Froster2406/BAT2024/Dokumentation/presentation/BAT_Beispiele_Zwischenpraesentation.docx

LEDs

Mikrofon

Speicher

V1-1 Back

V1-1 Front

Adapter

Debugger

Stefano Nicora

Entwicklung einer PCB zur Analyse von Umgebungslärm
