Froster2406/BAT2024/Dokumentation/presentation/BAT-EIT-FS24-Präs-Nicora-1507146.pptx

## BAT FS24

Gerät zur Überwachung von Umgebungslärm

Schlusspräsentation – 19.06.2024

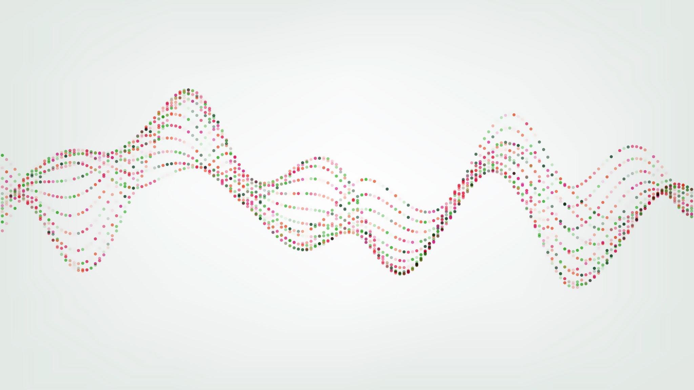
[picture p70: figure]

## Ablauf

Ausgangslage
Ziel
Implementation
Resultate
Fallstricke
Fazit & Ausblick

## Ausgangslage

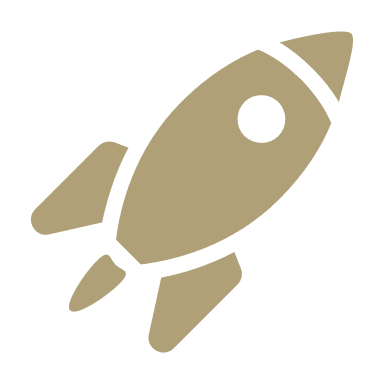
[picture p71: figure]
Rakete
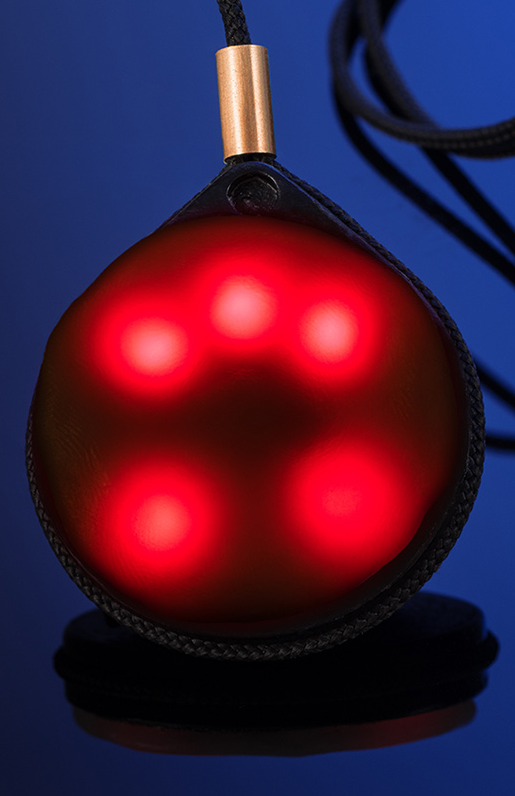
[picture p72: figure]

Bestehende Geräte unhandlich, gross, optisch nicht schön
Masterarbeit von Sophie Willener ( hEar)
Mockup bestehend aus:
LED-Ring
ESP32-Mikrocontroller
Kondensator-Mikrofon
Akku (nicht im Betrieb)
Gesamtdurchmesser 40mm

## Ziel

- Schalldruckpegel visuell darstellen
- MEMS-Mikrofon
- Akkubetrieb für >12h (Arbeitstag)
- BLE-fähig
- USB-C Ladefähigkeit
- Optisch ansprechendes Design
- Messungen speichern und bei Bedarf übertragen
(Übertragung ist nicht Inhalt dieser Arbeit)

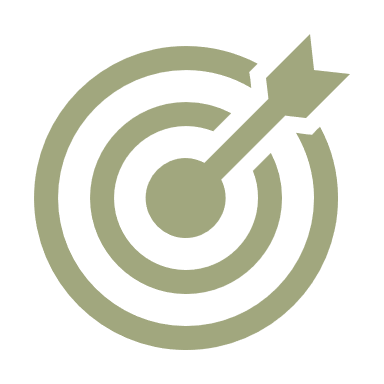
[picture p73: figure]
Volltreffer
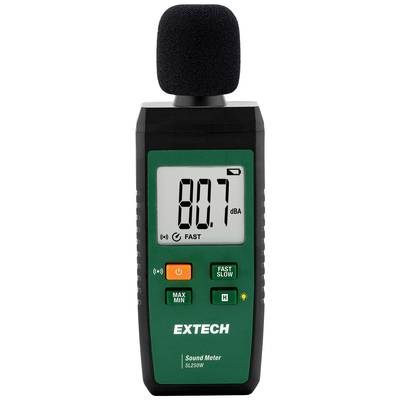
[picture p74: figure]

## Software

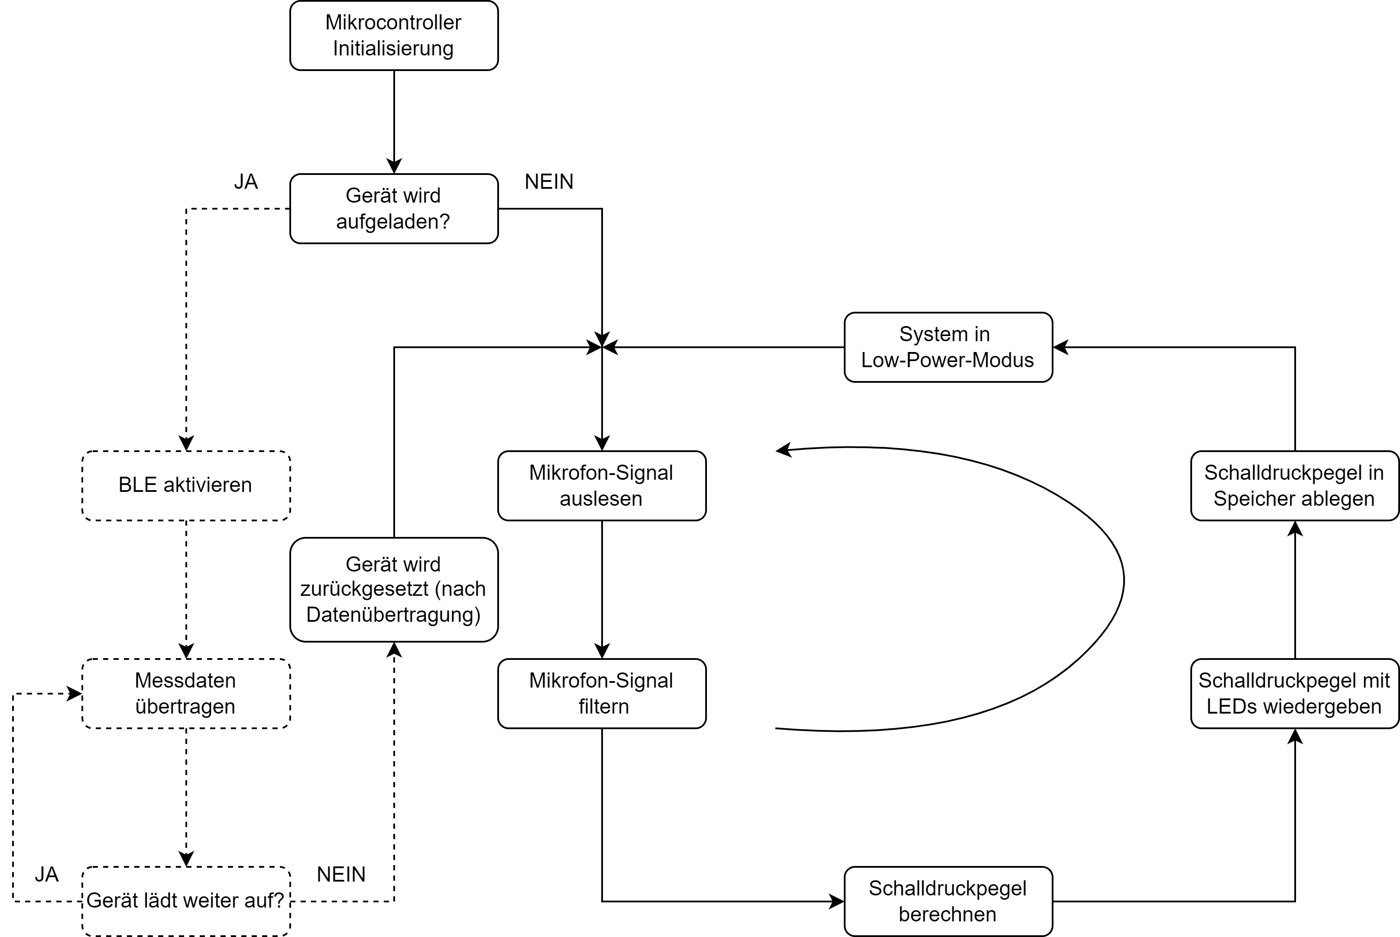
[picture p75: figure]

## Signalverarbeitung Überblick

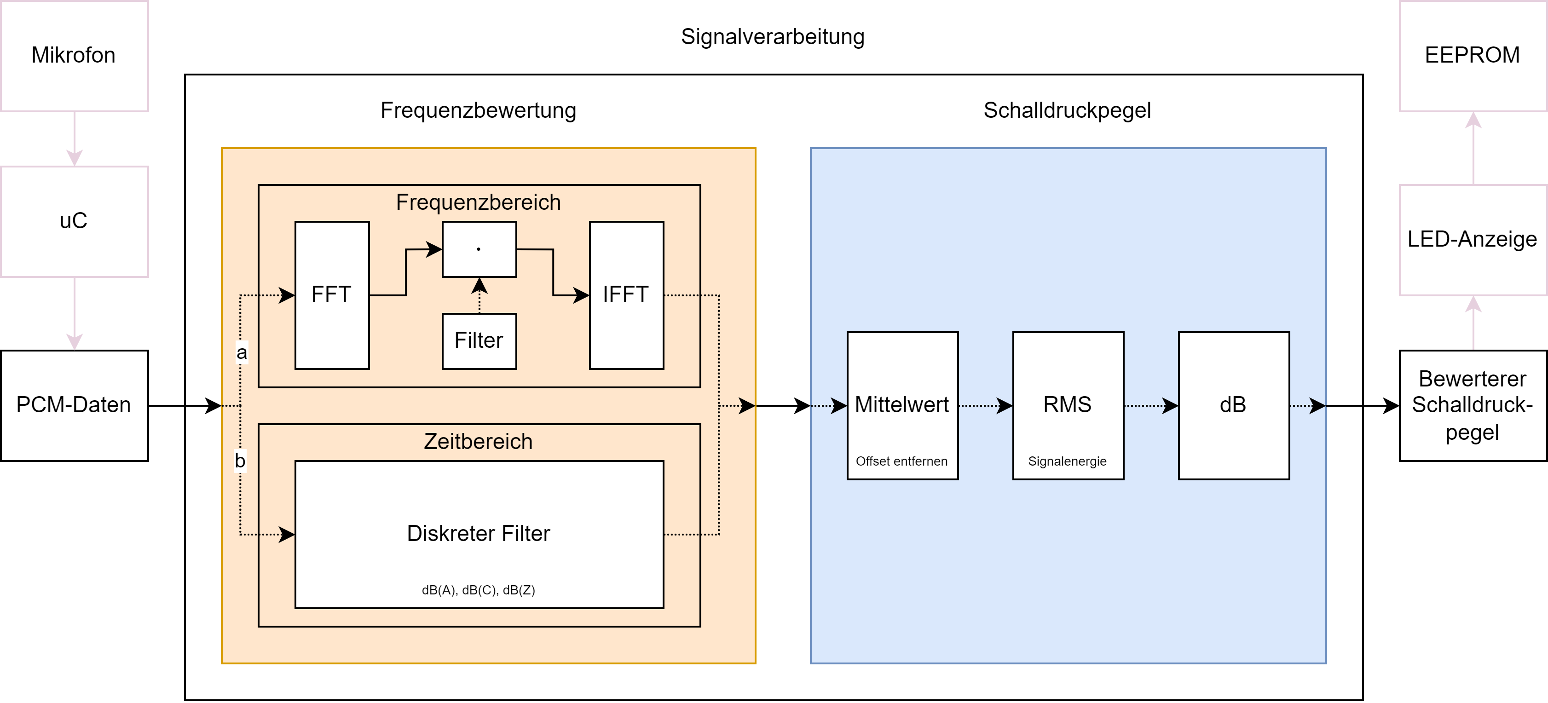
[picture p76: figure]

## Signalverarbeitung Frequenzbewertung

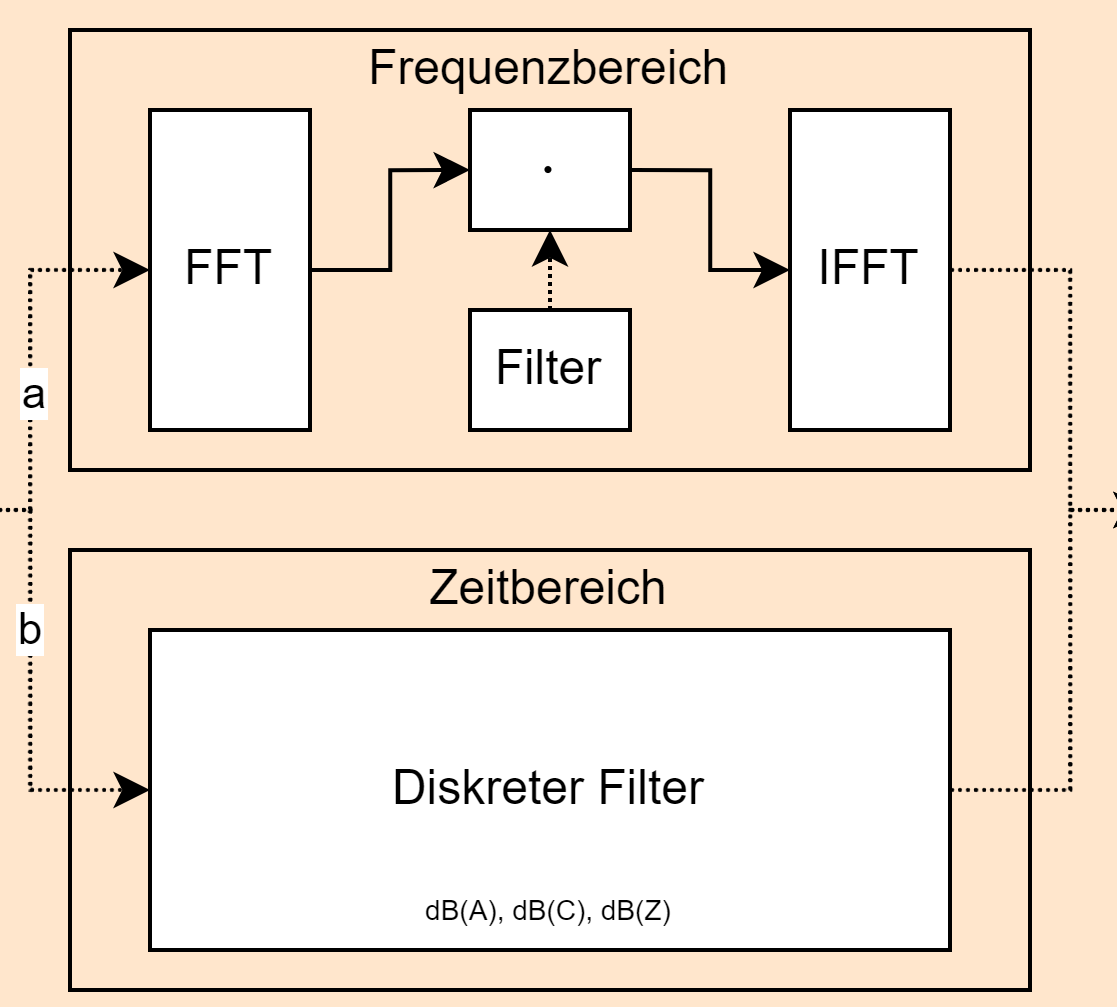
[picture p77: figure]
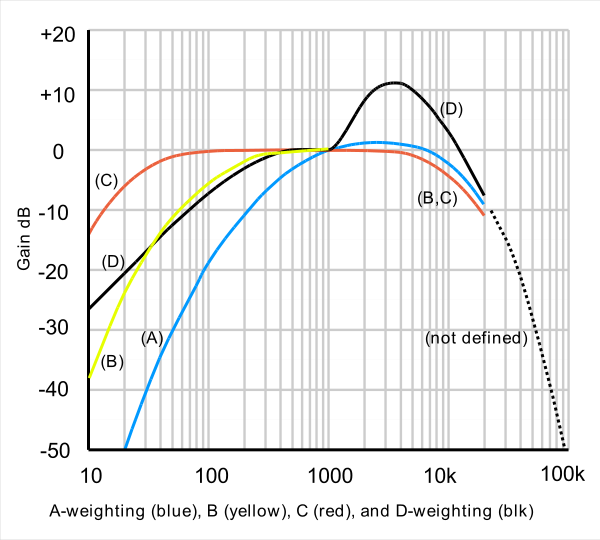
[picture p78: figure]

## Signalverarbeitung Schalldruckpegel - Mittelwert

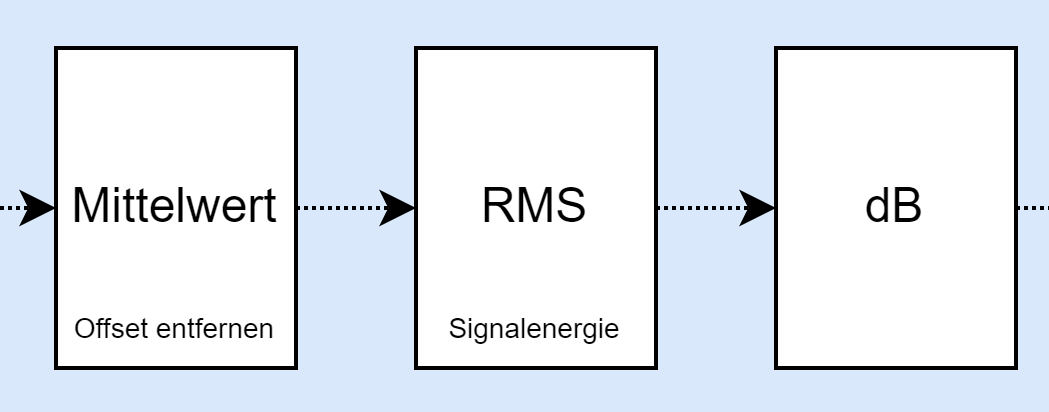
[picture p79: figure]

## Signalverarbeitung Schalldruckpegel - RMS

## Signalverarbeitung Schalldruckpegel - dBSPL

dBSPL=129.5+20⋅log_10 ((RMS)/8388607)


## Hardware

60mm


Back

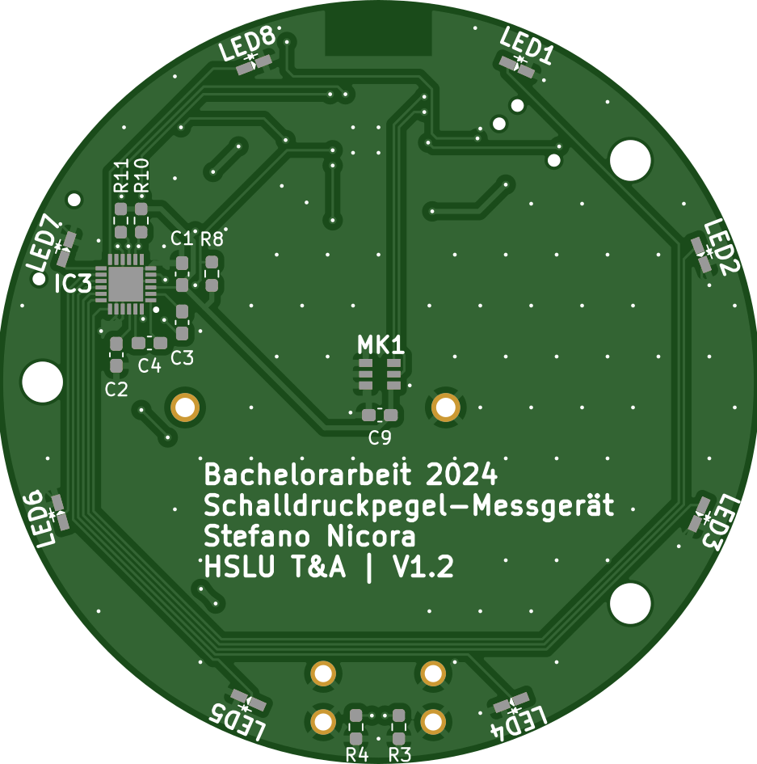
[picture p80: figure]

Front

## Hardware


V1-2

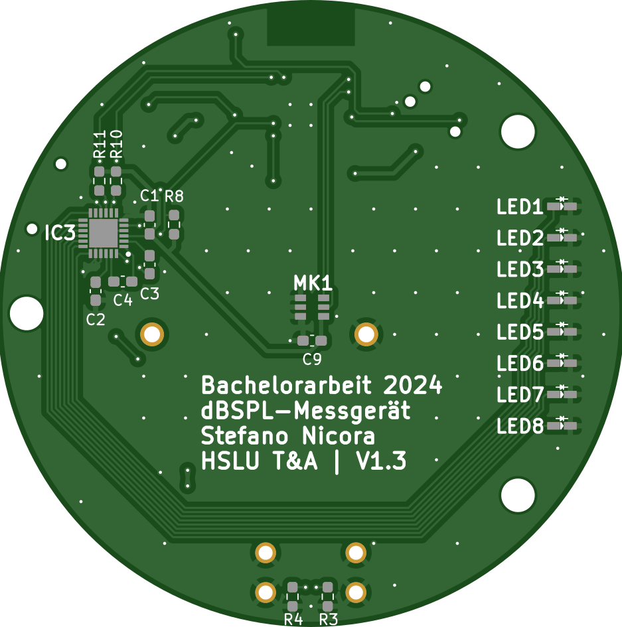
[picture p81: figure]

V1-3

## Resultate Rechenzeit

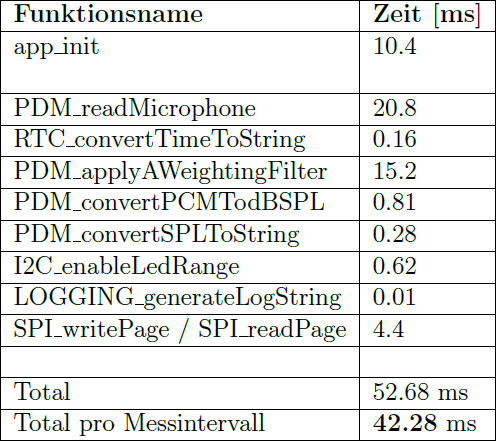
[picture p82: figure]

## Resultate Energie

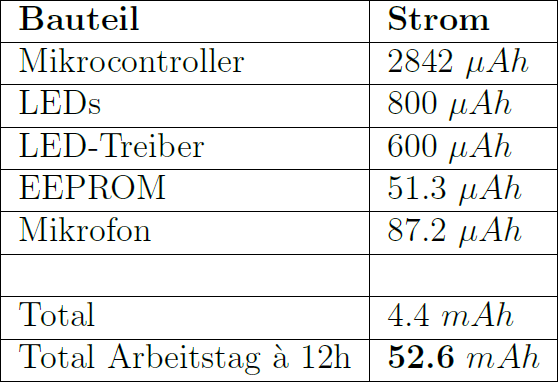
[picture p83: figure]

Berechnet

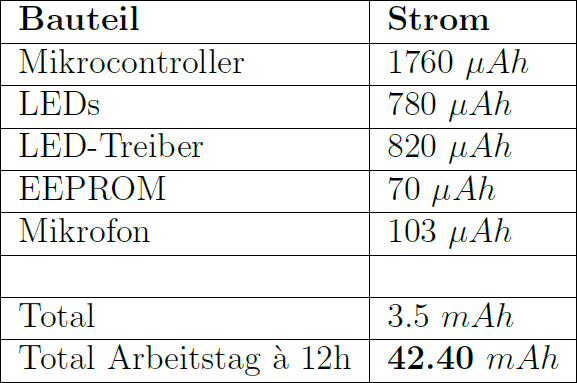
[picture p84: figure]

Gemessen

## Resultate Mikrofon

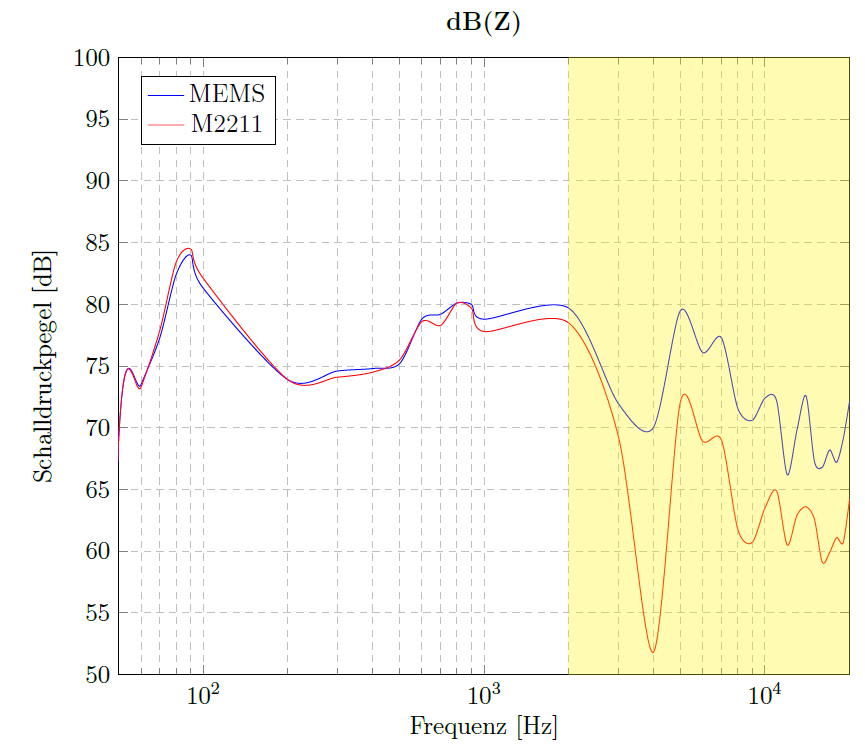
[picture p85: figure]
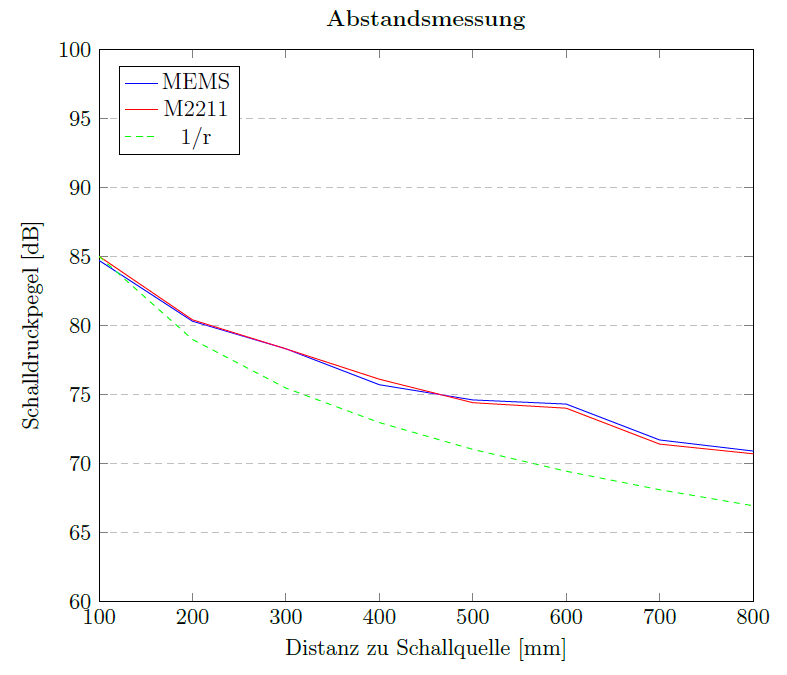
[picture p86: figure]

Helmholtz-Effekt

## Resultate Mikrofon

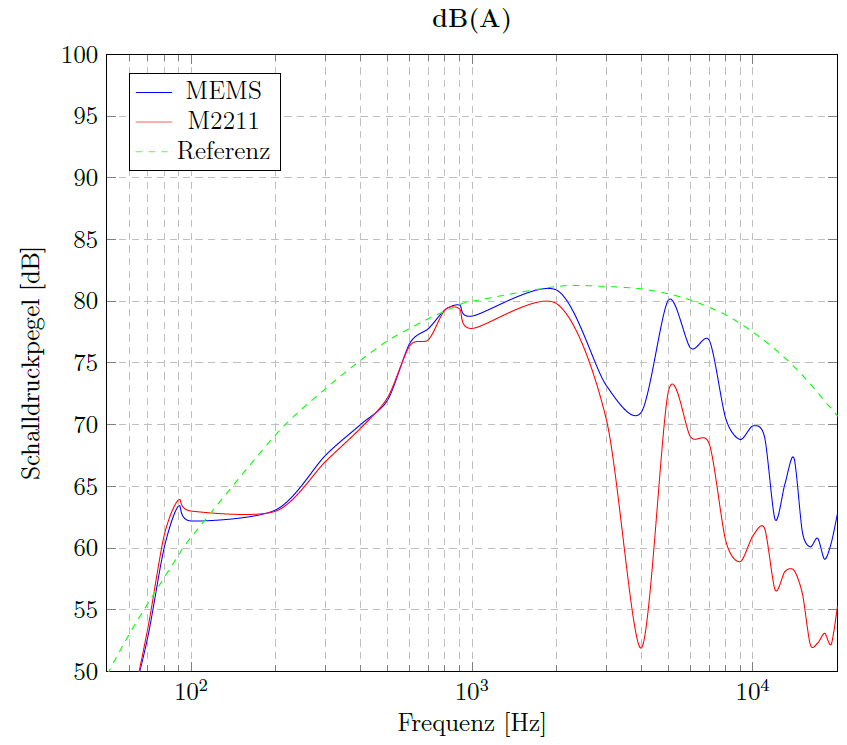
[picture p87: figure]
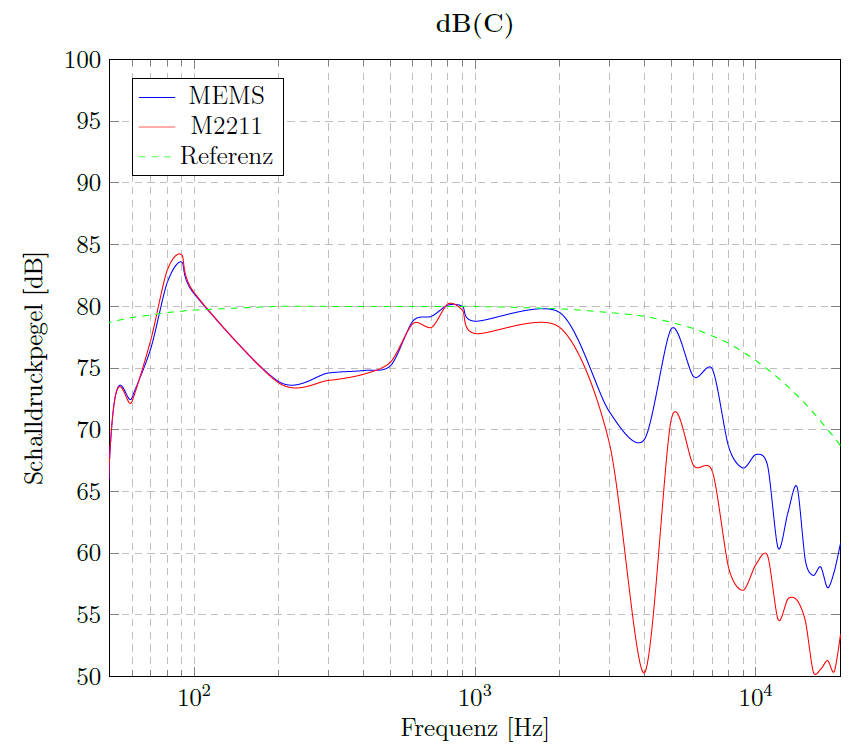
[picture p88: figure]

## Fallstricke Zeitgewichtung

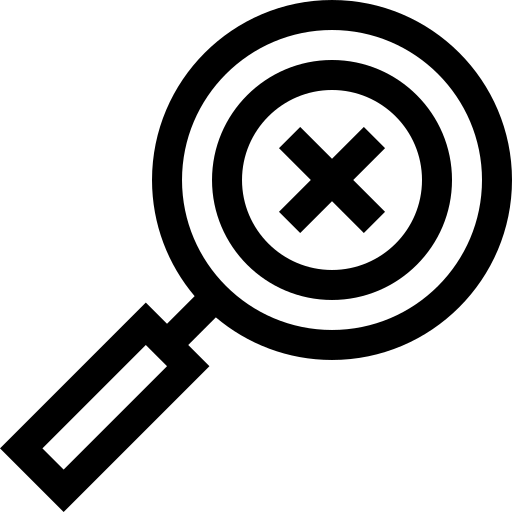
[picture p89: figure]

## Fallstricke SNR / Rauschboden

- Mögliche Ursachen:
  - Clock-Stabilität
  - Spannungsversorgung
  - Standby-Modus Mikrofon

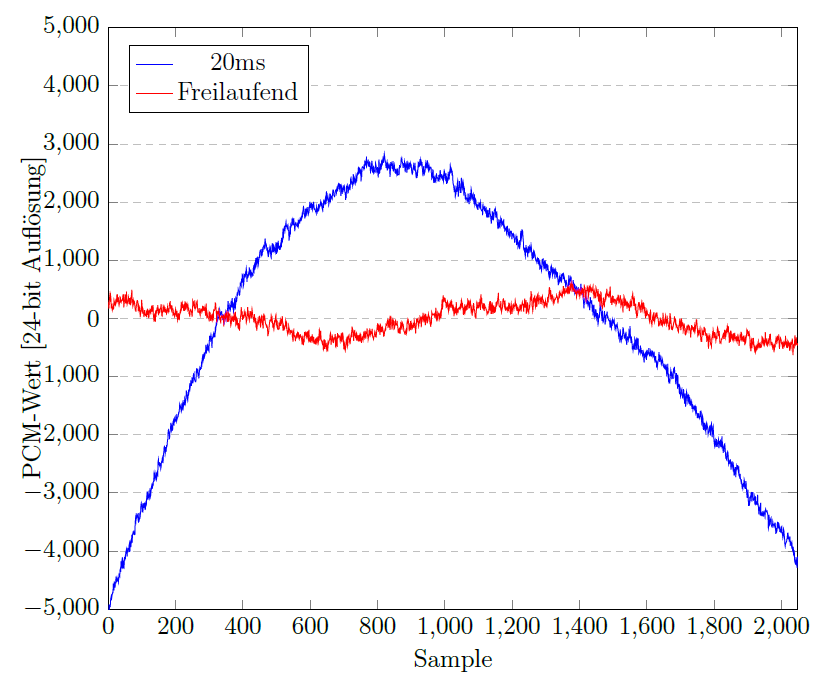
[picture p90: figure]

## Fazit & Ausblick

- Ziele wurden erreicht
- Implementation BLE-Funktionalität
- Bluetooth-Zertifizierung
- Zeitgewichtung
- Rauschboden-Optimierung
- Sensitivitätsfilter
- RTC

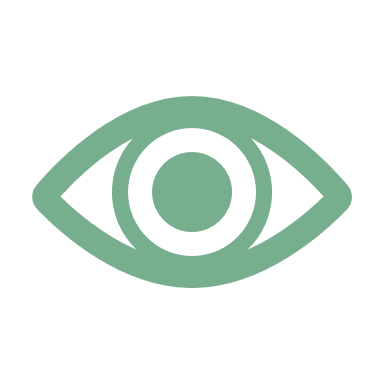
[picture p91: figure]
Auge
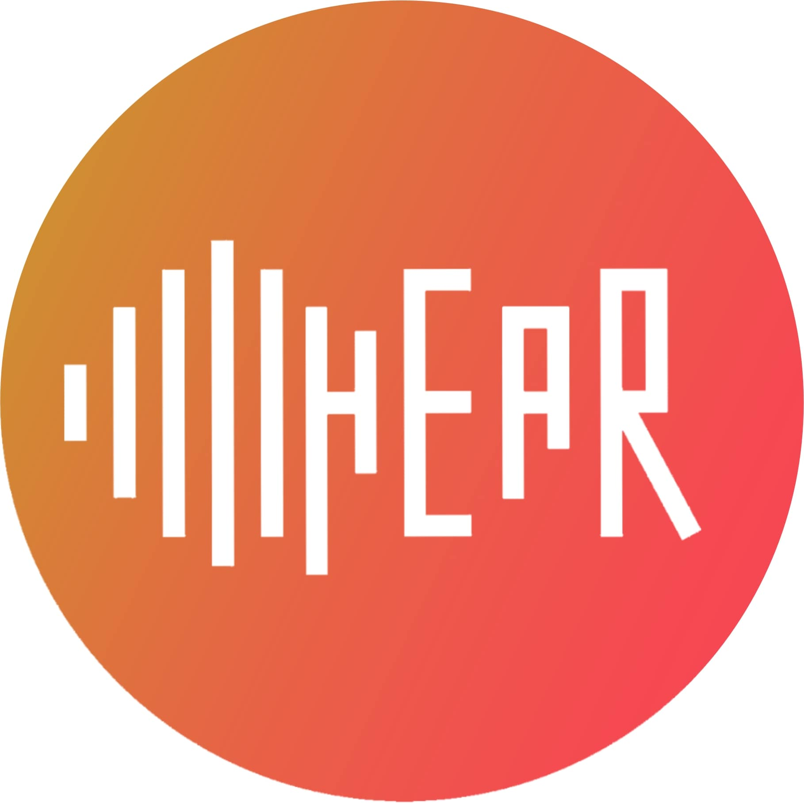
[picture p92: figure]

## Vielen Dank für ihre aufmerksamkeit

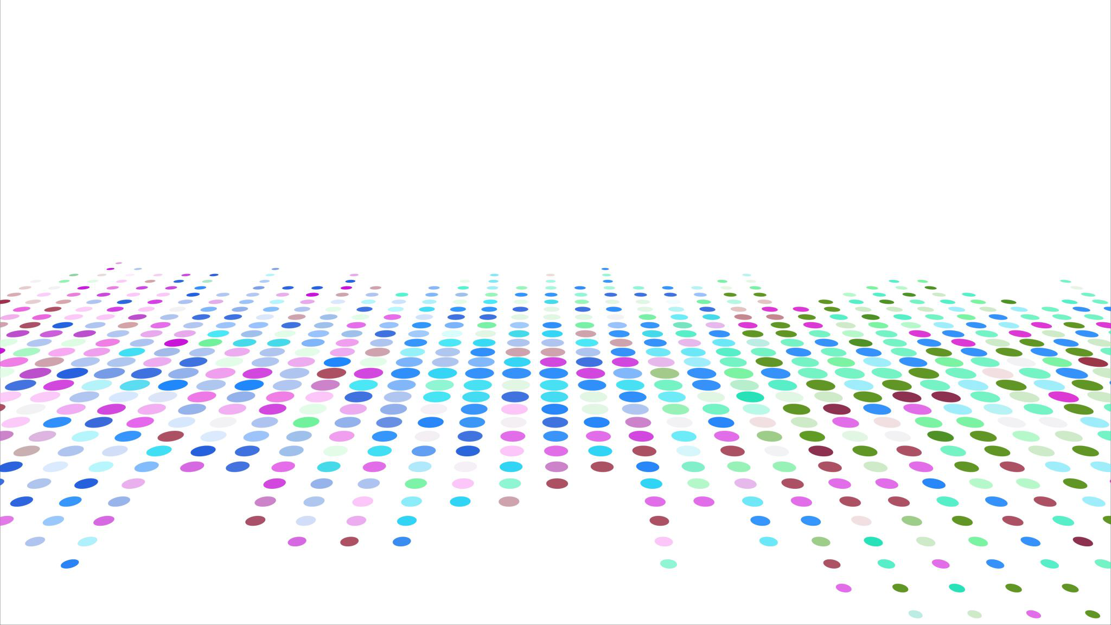
[picture p93: figure]
