Froster2406/BAT2024/Dokumentation/images/BAT_Ansicht_Back.png

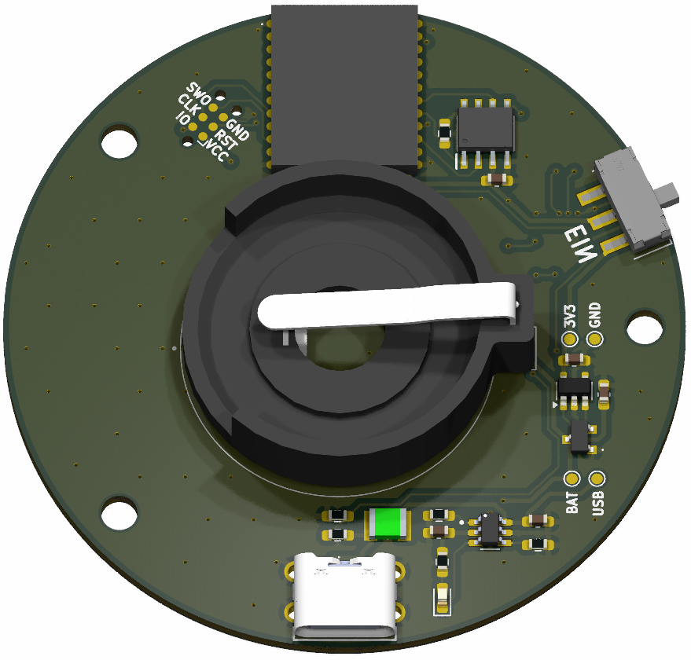
Dokumentation/images/BAT_Ansicht_Back.png
