Froster2406/BAT2024/Dokumentation/images/BAT_Ansicht_Front.png

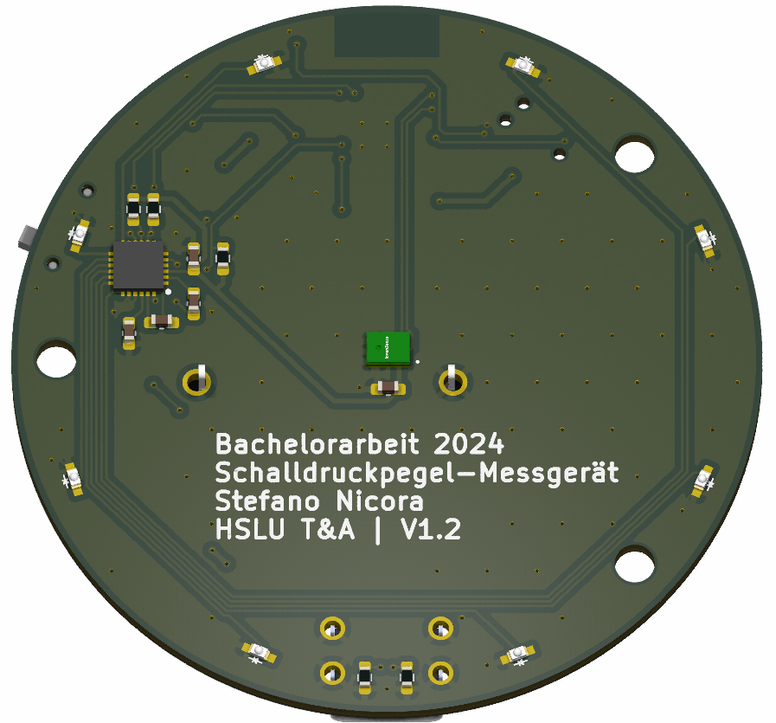
Dokumentation/images/BAT_Ansicht_Front.png
