Froster2406/BAT2024/Dokumentation/images/BAT_Flussdiagramm_I2C.png

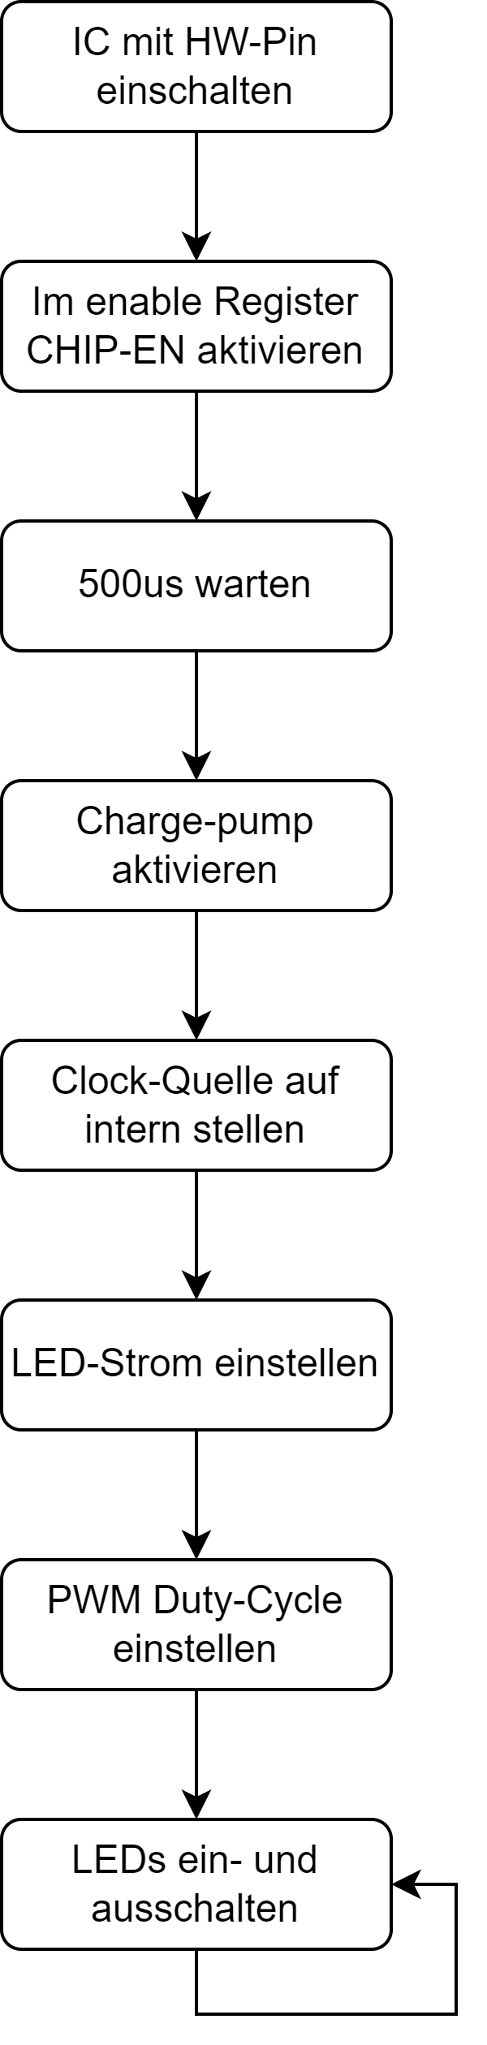
Dokumentation/images/BAT_Flussdiagramm_I2C.png
