Froster2406/BAT2024/Dokumentation/images/BAT_PDM-vs-PWM.png

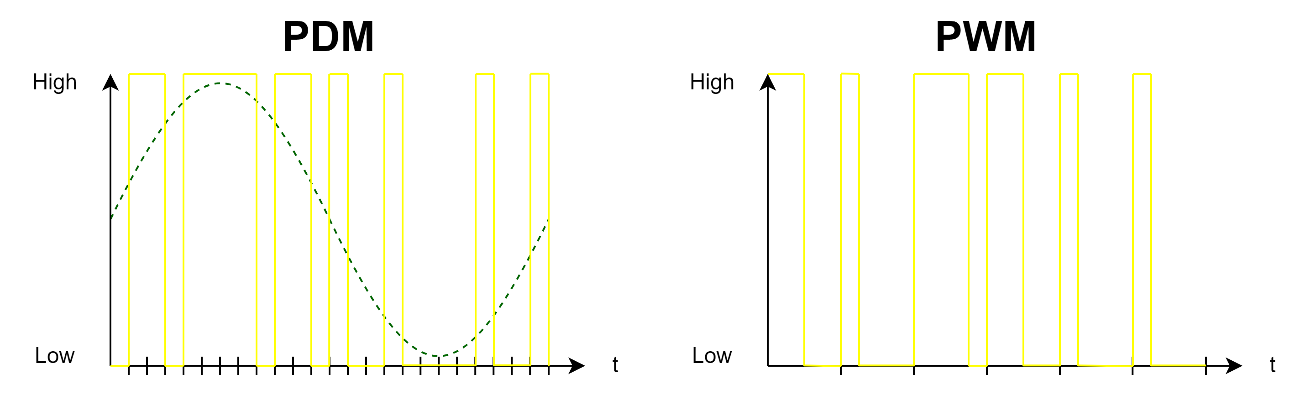
Dokumentation/images/BAT_PDM-vs-PWM.png
