Froster2406/BAT2024/Dokumentation/presentation/BAT2024_b.png

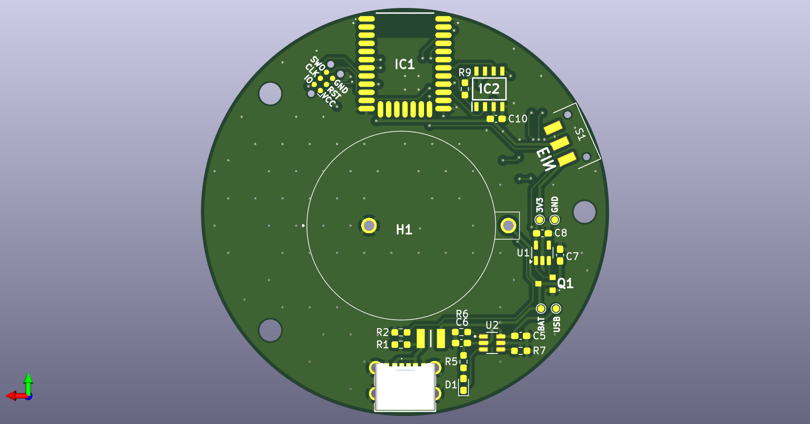
Dokumentation/presentation/BAT2024_b.png
