Froster2406/BAT2024/Dokumentation/presentation/BAT2024_f.png

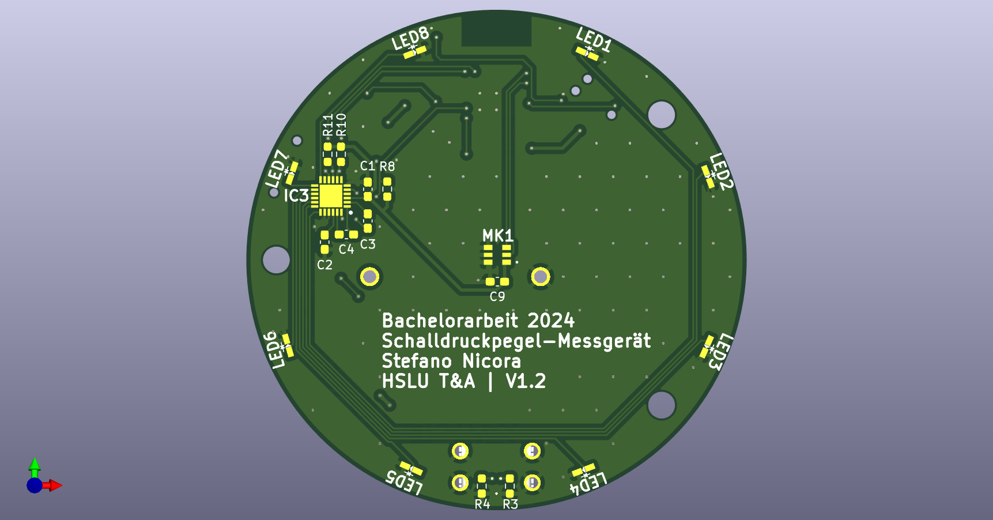
Dokumentation/presentation/BAT2024_f.png
