Froster2406/BAT2024/Hardware/BAT_PCB_Durchmesser_60mm.png

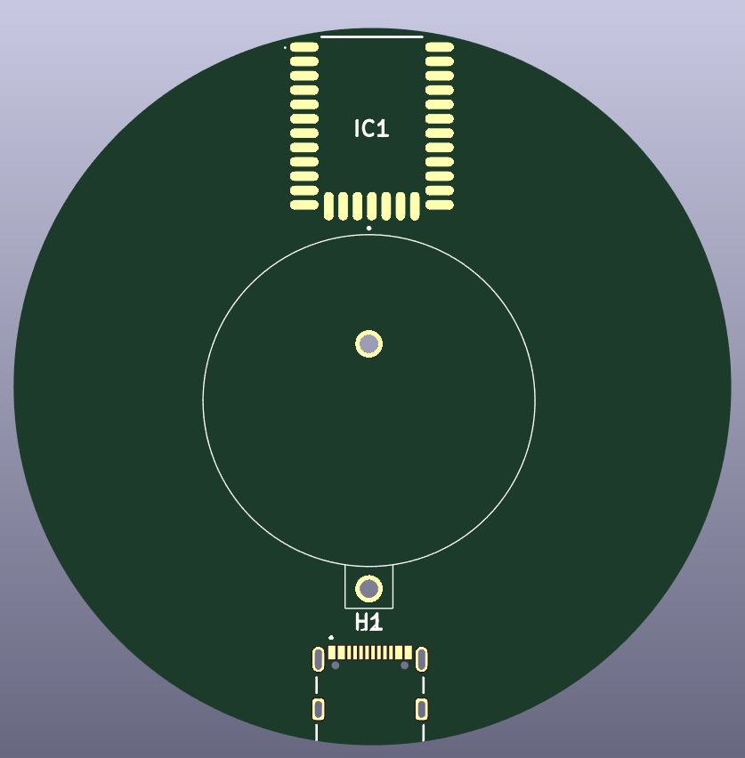
Hardware/BAT_PCB_Durchmesser_60mm.png
