Froster2406/BAT2024/Hardware/BAT_PCB_Vergleich_Durchmesser.png

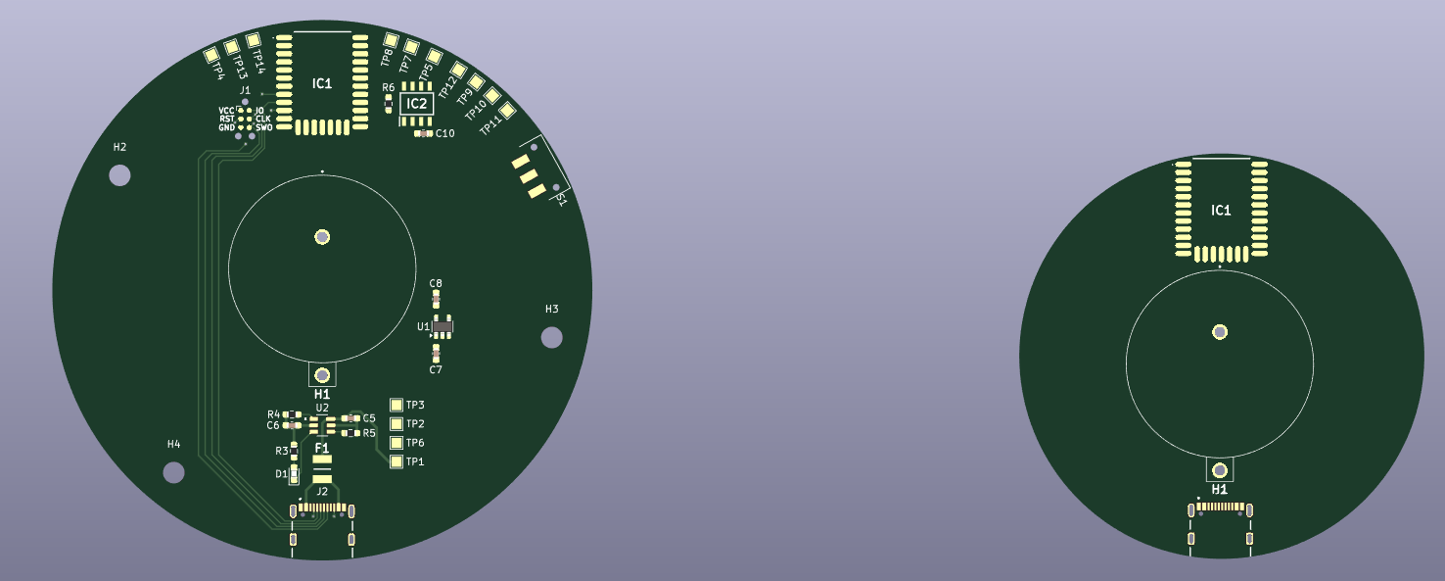
Hardware/BAT_PCB_Vergleich_Durchmesser.png
