Froster2406/BAT2024/Dokumentation/tables/BAT_Materialliste.tex

\begin{table}[!ht]
	\centering
	\begin{tabular}{|l|l|l|l|}
		\hline
		\textbf{Hersteller} & \textbf{Typ} & \textbf{Bezeichnung} & \textbf{Preis/100} \\ \hline
		JLCPCB & \href{https://cart.jlcpcb.com/quote?orderType=1\&stencilLayer=2\&stencilWidth=40\&stencilLength=40\&stencilCounts=100}{-} & PCB inkl. Versand & 0.394 \\ \hline
		Texas Instruments  & \href{https://www.mouser.ch/ProductDetail/Texas-Instruments/BQ21040DBVR?qs=cttFivMKqWyovUuY6Xwwcw\%3D\%3D}{BQ21040DBVR} & Batterie-Management & 0.516 \\ \hline
		Microchip Technology & \href{https://www.mouser.ch/ProductDetail/Microchip-Technology/MIC5504-3.3YM5-TR?qs=U6T8BxXiZAUmVQ5Zs217qQ\%3D\%3D}{MIC5504-3.3YM5-TR}  & 3V3 LDO & 0.095 \\ \hline
		RS PRO & \href{https://ch.rs-online.com/web/p/knopfzellen-akkus/1834296}{LIR2477} & Akku & 4.085 \\ \hline
		Littlefuse & \href{https://www.mouser.ch/ProductDetail/Littelfuse/1210L020WR?qs=PWhpLWeW8wcFhN6lPv0ohQ%3D%3D}{1210L020WR} & Rückstellbare Sicherung & 0.205 \\ \hline
		Texas Instruments  & \href{https://www.mouser.ch/ProductDetail/Texas-Instruments/LP55231SQX-NOPB?qs=HF2YfZwisE8IcIRPR19gTw\%3D\%3D}{LP55231SQX/NOPB}  & 9-Kanal LED-Treiber IC & 1.35 \\ \hline
		SunLED & \href{https://www.digikey.ch/de/products/detail/sunled/XZCM2CRK53WA-8VF/10449794}{XZCM2CRK53WA-8VF} & LED RED CLEAR 2SMD & 0.2072 \\ \hline
		C\&K & \href{https://www.mouser.ch/ProductDetail/CK/JS102011SAQN?qs=LgMIjt8LuD\%252B69bNM9a\%2FozQ\%3D\%3D}{JS102011SAQN}  & Schalter 0.3A@6V & 0.453 \\ \hline
		Keystone Electronics & \href{https://www.mouser.ch/ProductDetail/Keystone-Electronics/1025-7?qs=2eeJ4RqLicExTS\%2FpSQucQQ\%3D\%3D}{1025-7}  & Batteriehalter 24x7.7mm & 1.26 \\ \hline
		STMicroelectronics & \href{https://www.mouser.ch/ProductDetail/STMicroelectronics/M95P16-IXMNT-E?qs=rQFj71Wb1eV9LflyHvgrDg\%3D\%3D}{M95P16-IXMNT/E}  & 16MBit SPI EEPROM & 0.843 \\ \hline
		Silicon Labs & \href{https://www.mouser.ch/ProductDetail/Silicon-Labs/BGM220PC22WGA2R?qs=7MVldsJ5UayRQss0gz56jA\%3D\%3D}{BGM220PC22WGA2R}  & Mikrocontroller & 6.33 \\ \hline
		TDK InvenSense & \href{https://www.mouser.ch/ProductDetail/TDK-InvenSense/ICS-41351?qs=\%252B6g0mu59x7LDJ1mBnROZzA\%3D\%3D}{ICS-41351}  & MEMS-Mikrofon & 1.05 \\ \hline
		GCT & \href{https://www.mouser.ch/ProductDetail/GCT/USB4125-GF-A?qs=KUoIvG\%2F9IlaIQ4zBJ6gLeA\%3D\%3D}{640-USB4125-GF-A} & USB-C Buchse 6 Pin TOP & 0.381 \\ \hline
		Toshiba & \href{https://www.mouser.ch/ProductDetail/Toshiba/SSM3J334RLF?qs=PiFplXvYe5VBSYhr6TJz8A\%3D\%3D}{SSM3J334R,LF} & P-Channel MOSFET & 0.109 \\ \hline
		Diverse & Capacitor \& Resistor & Abmessung: 0603 & 0.6 \\\hline
		~ & ~ & ~ & \textbf{17.90 CHF} \\ \hline
	\end{tabular}
	\caption{Materialliste $\vert$ Stand: 01.04.2024}
	\label{table:materialliste}
\end{table}
