Froster2406/BAT2024/Hardware/BAT_Materialliste.xlsx

Hersteller | Typ | Bezeichnung | URL | Preis / Stk | Preis / 100 | Zusatz | Bestellt | Erhalten
JLCPCB | - | PCB inkl. Versand | https://cart.jlcpcb.com/quote?orderType=1&stencilLayer=2&stencilWidth=40&stencilLength=40&stencilCounts=100 | 1.65 | 0.394 |  | X | X
Texas Instruments | BQ21040DBVR | Batterie-Management | https://www.mouser.ch/ProductDetail/Texas-Instruments/BQ21040DBVR?qs=cttFivMKqWyovUuY6Xwwcw%3D%3D | 0.77 | 0.516 |  | X | X
Microchip Technology | MIC5504-3.3YM5-TR | 3V3 LDO | https://www.mouser.ch/ProductDetail/Microchip-Technology/MIC5504-3.3YM5-TR?qs=U6T8BxXiZAUmVQ5Zs217qQ%3D%3D | 0.14 | 0.095 |  | X | X
RS PRO | LIR2477 | Akku | https://ch.rs-online.com/web/p/knopfzellen-akkus/1834296 | 4.589 | 4.085 |  | X | X
Littlefuse | 1210L020WR | Rückstellbare Sicherung | https://www.mouser.ch/ProductDetail/Littelfuse/1210L020WR?qs=PWhpLWeW8wcFhN6lPv0ohQ%3D%3D | 0.31 | 0.205 |  | X | X
Texas Instruments | LP55231SQX/NOPB | 9-Kanal LED-Treiber IC | https://www.mouser.ch/ProductDetail/Texas-Instruments/LP55231SQX-NOPB?qs=HF2YfZwisE8IcIRPR19gTw%3D%3D | 1.87 | 1.35 |  | X | X
SunLED | XZCM2CRK53WA-8VF | LED RED CLEAR 2SMD | https://www.digikey.ch/de/products/detail/sunled/XZCM2CRK53WA-8VF/10449794 | 0.49 | 0.2072 |  | X | X
GCT | USB4105-GF-A-060 | USB-C Buchse 16 Pin TOP | https://www.mouser.ch/ProductDetail/GCT/USB4105-GF-A-060?qs=QNEnbhJQKvY2mocwNJzgfA%3D%3D |  |  |  | X | X
C&K | JS102011SAQN | Schalter 0.3A/6V | https://www.mouser.ch/ProductDetail/CK/JS102011SAQN?qs=LgMIjt8LuD%252B69bNM9a%2FozQ%3D%3D | 0.61 | 0.453 |  | X | X
Keystone Electronics | 1025-7 | Batteriehalter 24x7.7mm | https://www.mouser.ch/ProductDetail/Keystone-Electronics/1025-7?qs=2eeJ4RqLicExTS%2FpSQucQQ%3D%3D | 1.8 | 1.26 |  | X | X
STMicroelectronics | M95P16-IXMNT/E | 16MBit SPI EEPROM | https://www.mouser.ch/ProductDetail/STMicroelectronics/M95P16-IXMNT-E?qs=rQFj71Wb1eV9LflyHvgrDg%3D%3D | 1.12 | 0.843 | Optional | X | X
Silicon Labs | BGM220PC22WGA2R | Mikrocontroller | https://www.mouser.ch/ProductDetail/Silicon-Labs/BGM220PC22WGA2R?qs=7MVldsJ5UayRQss0gz56jA%3D%3D | 8.44 | 6.33 |  | X | X
TDK InvenSense | ICS-41351 | MEMS-Mikrofon | https://www.mouser.ch/ProductDetail/TDK-InvenSense/ICS-41351?qs=%252B6g0mu59x7LDJ1mBnROZzA%3D%3D | 1.55 | 1.05 |  | X | X
GCT | 640-USB4125-GF-A | USB-C Buchse 6 Pin TOP | https://www.mouser.ch/ProductDetail/GCT/USB4125-GF-A?qs=KUoIvG%2F9IlaIQ4zBJ6gLeA%3D%3D | 0.579 | 0.381 |  | X
Toshiba | SSM3J334R,LF | P-Channel MOSFET | https://www.mouser.ch/ProductDetail/Toshiba/SSM3J334RLF?qs=PiFplXvYe5VBSYhr6TJz8A%3D%3D | 0.364 | 0.109 |  | X
 |  |  |  | 24.282 | 17.2782 | CHF
Silicon Labs | BGM220-EK4314A | Mikrocontroller Devboard | https://www.mouser.ch/ProductDetail/Silicon-Labs/BGM220-EK4314A |  |  | 8.98
