Froster2406/BAT2024/Dokumentation/tables/BAT_Berechnung_Energiebedarf_Gesamt.xlsx

Energiebedarf Gesamtsystem
Anzahl LEDs | 8 |  |  | 12 | h | Laufzeit Gerät Total
Leistungsaufnahme pro LED | 0.1 | mA
Leistungsaufnahme Total LEDs | 0.8 | mA
= | 9.6 | mAh
Leitungsaufnahme uController | 100 | uA/MHz |  | 1 | MHz | Taktrate uController
= | 1.2 | mAh
Energiebedarf total | 10.8 | mAh
Faktor Leistungsaufnahme LEDs > uController | 8
Berechnet |  |  |  |  |  | Gemessen
Mikrocontroller | 2842 | uAh |  |  |  | Mikrocontroller | 1760 | uAh
LEDs | 800 | uAh |  |  |  | LEDs | 780 | uAh
LED-Treiber | 600 | uAh | Alle Ausgänge EIN |  |  | LED-Treiber | 820 | uAh
EEPROM | 51.3 | uAh |  |  |  | EEPROM | 70 | uAh
Mikrofon | 87.2 | uAh |  |  |  | Mikrofon | 103 | uAh
total | 4.3805 | mAh |  |  |  | total | 3.533 | mAh
Total Arbeitstag à 12h | 52.566 | mAh |  |  |  | Total Arbeitstag à 12h | 42.396 | mAh
