Froster2406/BAT2024/Dokumentation/tables/BAT_Berechnung_Energiebedarf_System.xlsx

Energiebedarf Gesamtsystem
Anzahl LEDs | 7 |  | 12 | h | Laufzeit Gerät Total
Leistungsaufnahme pro LED | 1 | mA
Leistungsaufnahme Total LEDs | 7 | mA
= | 84 | mAh
Leitungsaufnahme uController | 100 | uA/MHz | 1 | MHz | Taktrate uController
= | 1.2 | mAh
Energiebedarf total | 85.2 | mAh
Faktor Leistungsaufnahme LEDs > uController | 70
