Froster2406/BAT2024/Hardware/BAT_Breakout/fabrication-output/Fabrikationsauftrag_Hand.rtf

Produktionsauftrag: Printfabrikation

Allgemeine Hinweise:

Printgrösse: 12.1mm x 45.4mm
Min. Lochdurchmesser: …………………………………………………………………………….
Min. Leiterbahngrösse: 20 mil
Umsetzungsart: 1 Layer
______________________________________

Auftragsinformationen:

Name: Nicora
Vorname: Stefano
CC/Fach: BAT
Telefonnummer: 0765838651
Stückzahl 2
______________________________________

Auftragsname: BAT Breakout

Datum: 13.03.2024

Visum: S. Nicora
