Froster2406/BAT2024/Dokumentation/images/Messaufbau/Beide_Hinten.jpg

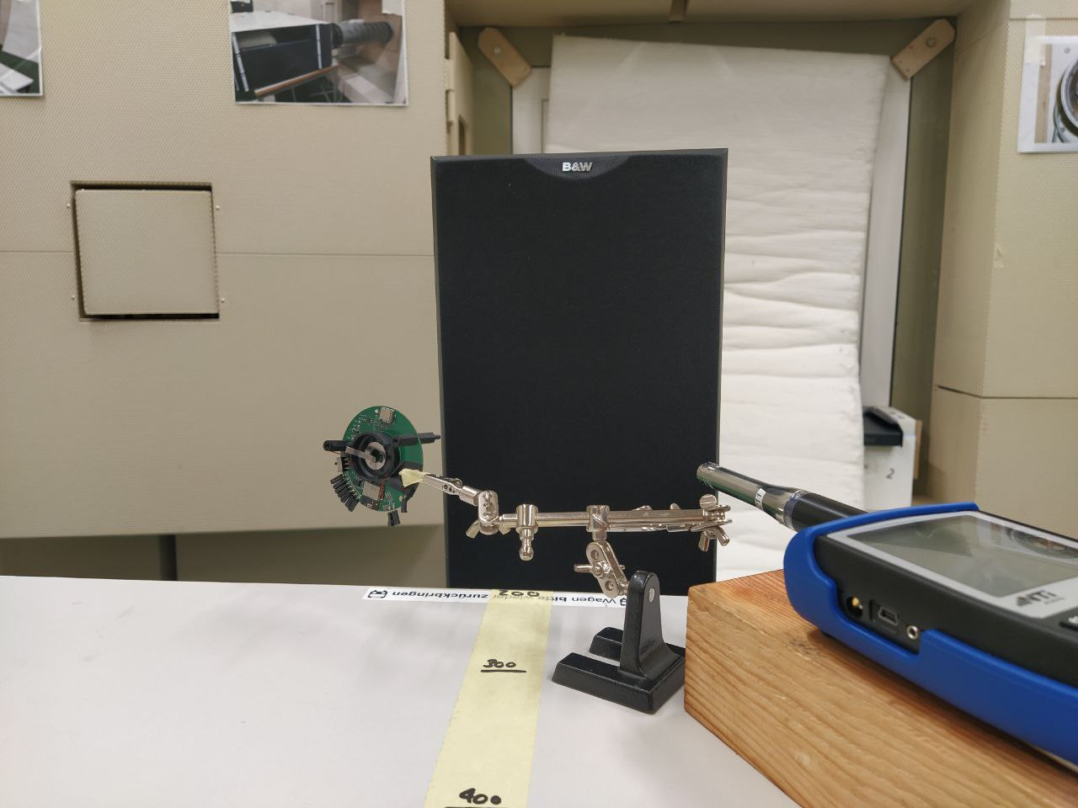
Dokumentation/images/Messaufbau/Beide_Hinten.jpg
