Froster2406/BAT2024/Dokumentation/images/Messaufbau/Beide_Top.jpg

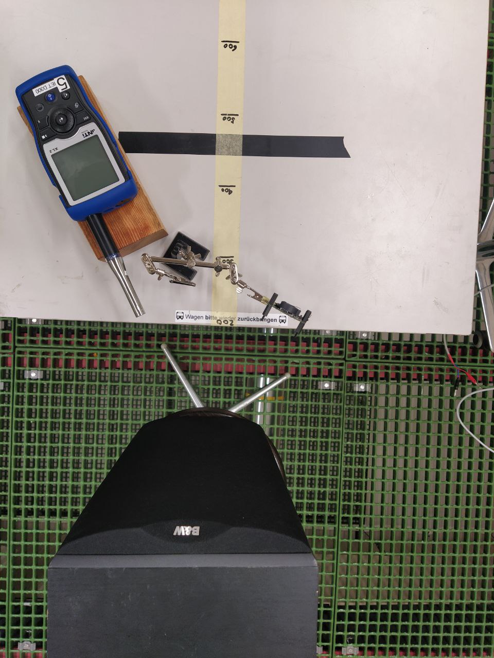
Dokumentation/images/Messaufbau/Beide_Top.jpg
