Froster2406/BAT2024/Dokumentation/images/Messaufbau/MEMS_Hinten.jpg

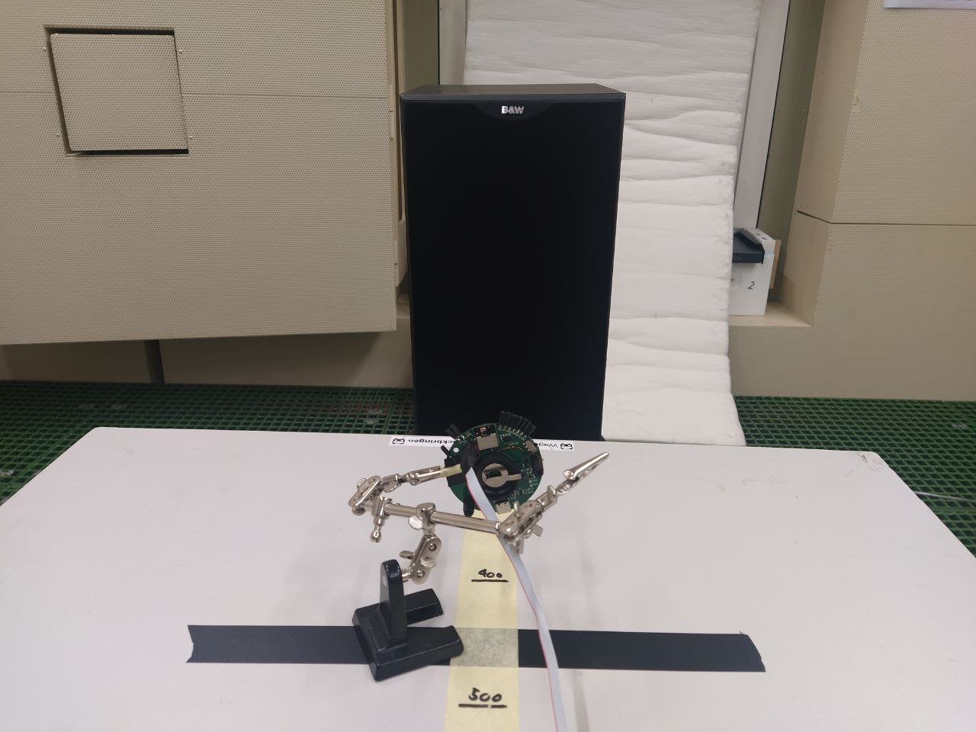
Dokumentation/images/Messaufbau/MEMS_Hinten.jpg
