Froster2406/BAT2024/Dokumentation/images/Messaufbau/MEMS_Top.jpg

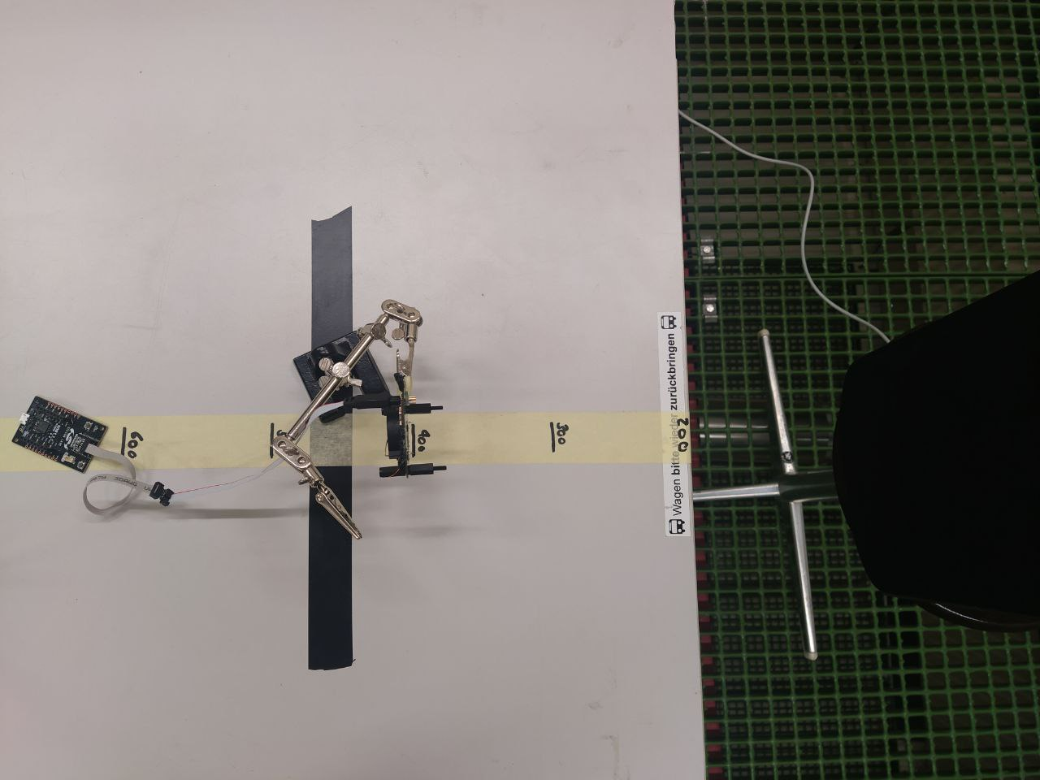
Dokumentation/images/Messaufbau/MEMS_Top.jpg
