Froster2406/BAT2024/Dokumentation/images/Messaufbau/NTI_Hinten.jpg

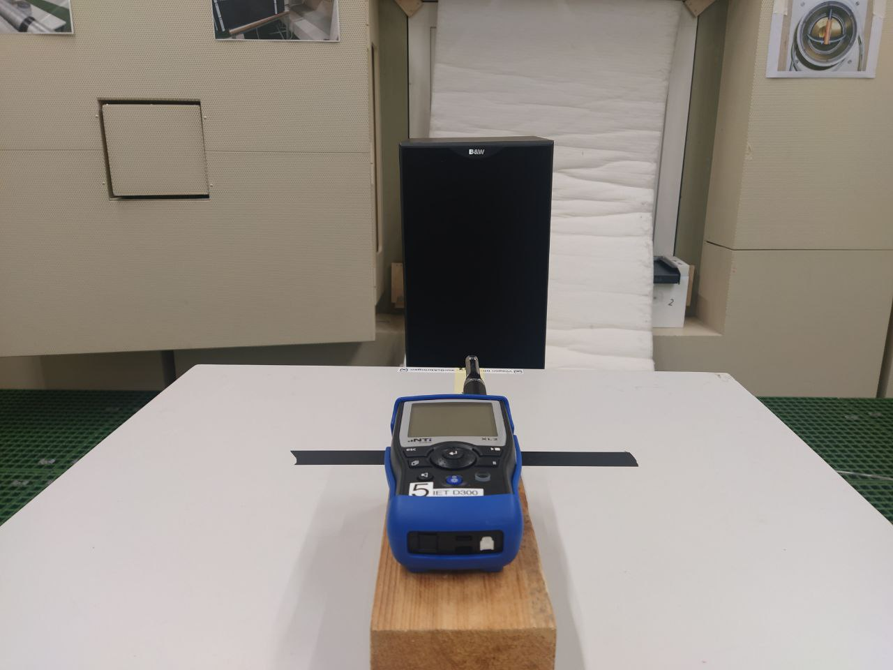
Dokumentation/images/Messaufbau/NTI_Hinten.jpg
