Froster2406/BAT2024/Dokumentation/images/Messaufbau/NTI_Top.jpg

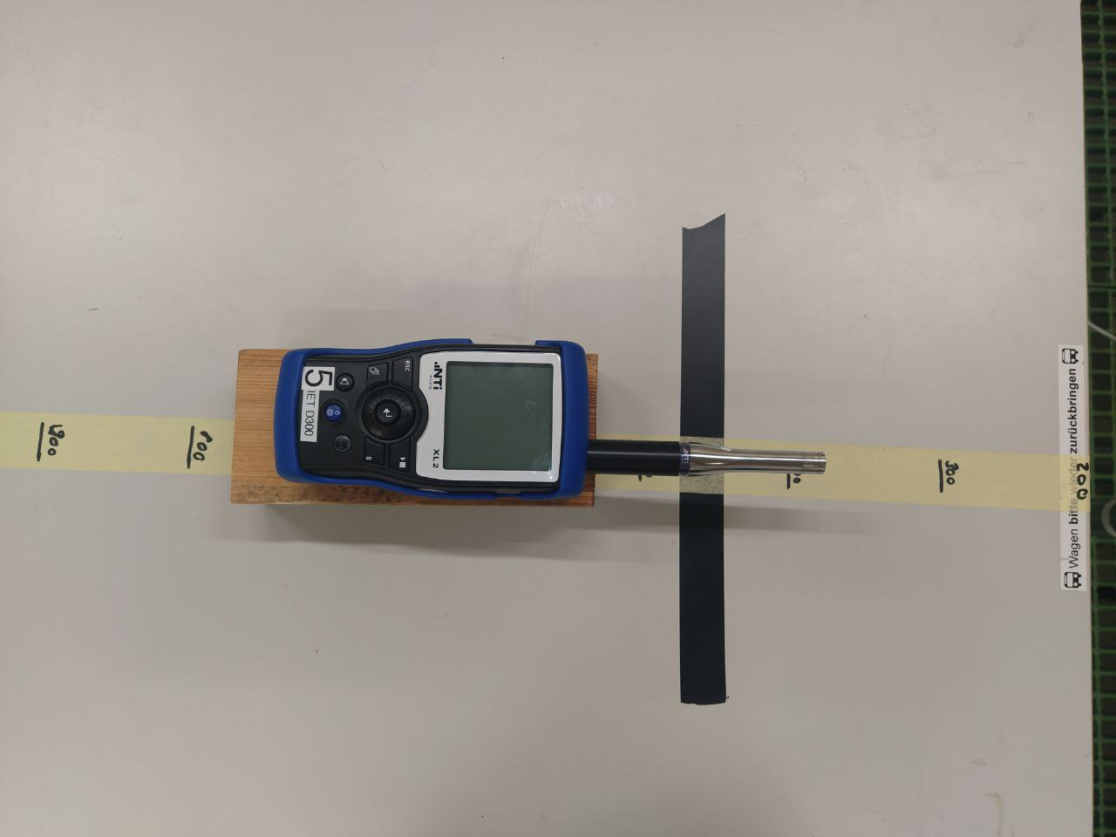
Dokumentation/images/Messaufbau/NTI_Top.jpg
