Froster2406/BAT2024/Dokumentation/measurements/Microphone/BAT_Datenumrechnung_Sinus_2.xlsx

 | Rohdaten 1kHz
 | 300685 | 279800 | 258476 | 238030 | 219150 | 201087 | 183789 | 165630 | 144348 | 119923 | 94915 | 73493 | 56692 | 42662 | 31234 | 23530 | 20245 | 19897 | 20291 | 21956 | 25273 | 31921 | 42187 | 56265 | 73310 | 91798 | 111052 | 130175 | 148902 | 167234 | 185802 | 204126 | 222435 | 242800 | 266981 | 288400 | 304096 | 316439 | 329735 | 341780 | 348756 | 351363 | 352512 | 352959 | 349914 | 343126 | 332948 | 319205 | 301057 | 280005 | 258520 | 238257 | 219392 | 201375 | 184152 | 166222 | 144975 | 120268 | 95193
 | Offset-Korrektur
MITTELWERT | 167468.1719 | 167468.1719 | 167468.1719 | 167468.1719 | 167468.1719 | 167468.1719 | 167468.1719 | 167468.1719 | 167468.1719 | 167468.1719 | 167468.1719 | 167468.1719 | 167468.1719 | 167468.1719 | 167468.1719 | 167468.1719 | 167468.1719 | 167468.1719 | 167468.1719 | 167468.1719 | 167468.1719 | 167468.1719 | 167468.1719 | 167468.1719 | 167468.1719 | 167468.1719 | 167468.1719 | 167468.1719 | 167468.1719 | 167468.1719 | 167468.1719 | 167468.1719 | 167468.1719 | 167468.1719 | 167468.1719 | 167468.1719 | 167468.1719 | 167468.1719 | 167468.1719 | 167468.1719 | 167468.1719 | 167468.1719 | 167468.1719 | 167468.1719 | 167468.1719 |
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
