Froster2406/BAT2024/Dokumentation/measurements/Microphone/BAT_Datenumrechnung_Rauschen.xlsx

 | Rohdaten 1kHz
 | 187944 | 187841 | 187959 | 188034 | 188080 | 188011 | 188053 | 187988 | 187839 | 187892 | 187902 | 187814 | 187843 | 187834 | 187871 | 187853 | 187971 | 187936 | 187909 | 187896 | 187953 | 187913 | 187933 | 187950 | 188024 | 187987 | 188082 | 188005 | 187950 | 188029 | 187928 | 187894 | 187928 | 187945 | 188032 | 188020 | 187951 | 187941 | 187978 | 187970 | 187979 | 187980 | 188041 | 188073 | 188073 | 187858 | 187915 | 187964 | 188008 | 188079 | 187936 | 187940 | 187936 | 188126 | 188013 | 187912 | 187938 | 187963 | 187969
 | Offset-Korrektur
MITTELWERT | 187665.6733 | 187665.6733 | 187665.6733 | 187665.6733 | 187665.6733 | 187665.6733 | 187665.6733 | 187665.6733 | 187665.6733 | 187665.6733 | 187665.6733 | 187665.6733 | 187665.6733 | 187665.6733 | 187665.6733 | 187665.6733 | 187665.6733 | 187665.6733 | 187665.6733 | 187665.6733 | 187665.6733 | 187665.6733 | 187665.6733 | 187665.6733 | 187665.6733 | 187665.6733 | 187665.6733 | 187665.6733 | 187665.6733 | 187665.6733 | 187665.6733 | 187665.6733 | 187665.6733 | 187665.6733 | 187665.6733 | 187665.6733 | 187665.6733 | 187665.6733 | 187665.6733 | 187665.6733 | 187665.6733 | 187665.6733 | 187665.6733 | 187665.6733 |
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
