Froster2406/BAT2024/Dokumentation/measurements/Timings/PDM_CLK_Jitter_Oszilloskop.csv

x-axis | 1
second | Volt
+35.617301000E-03 | +124.500036224E-03
+35.617302000E-03 | +155.750036208E-03
+35.617303000E-03 | +124.500036288E-03
+35.617304000E-03 | +124.500036240E-03
+35.617305000E-03 | +93.250036321E-03
+35.617306000E-03 | +124.500036142E-03
+35.617307000E-03 | +124.500036240E-03
+35.617308000E-03 | +155.750036109E-03
+35.617309000E-03 | +187.000036092E-03
+35.617310000E-03 | +155.750036403E-03
+35.617311000E-03 | +187.000036060E-03
+35.617312000E-03 | +187.000036240E-03
+35.617313000E-03 | +218.250036027E-03
+35.617314000E-03 | +187.000036469E-03
+35.617315000E-03 | +187.000036240E-03
+35.617316000E-03 | +155.750036502E-03
+35.617317000E-03 | +187.000035961E-03
+35.617318000E-03 | +187.000036240E-03
+35.617319000E-03 | +155.750036551E-03
+35.617320000E-03 | +155.750036240E-03
+35.617321000E-03 | +124.500036584E-03
+35.617322000E-03 | +155.750035879E-03
+35.617323000E-03 | +93.250036995E-03
+35.617324000E-03 | +124.500035846E-03
+35.617325000E-03 | +124.500036240E-03
+35.617326000E-03 | +124.500036240E-03
+35.617327000E-03 | +93.250036683E-03
+35.617328000E-03 | +124.500035780E-03
+35.617329000E-03 | +124.500036240E-03
+35.617330000E-03 | +155.750035747E-03
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
