Froster2406/BAT2024/Dokumentation/measurements/Microphone/BAT_Datenumrechnung_Sinus.xlsx

 | Rohdaten 1kHz
 | 728377 | 747027 | 768156 | 791731 | 817236 | 844391 | 872773 | 901400 | 930858 | 959296 | 986432 | 1011841 | 1036410 | 1059281 | 1079507 | 1096123 | 1110900 | 1121806 | 1129384 | 1134050 | 1134865 | 1132358 | 1126173 | 1116490 | 1103974 | 1088213 | 1069575 | 1048474 | 1024952 | 999577 | 972077 | 943691 | 914953 | 885467 | 857194 | 829063 | 802546 | 778061 | 755493 | 735320 | 717629 | 703070 | 691997 | 684139 | 680011 | 678453 | 681025 | 687122 | 696392 | 708578 | 724071 | 742401 | 763645 | 786786 | 811981 | 839547 | 867572 | 896691 | 925674
 | Offset-Korrektur
MITTELWERT | 893174.7012 | 893174.7012 | 893174.7012 | 893174.7012 | 893174.7012 | 893174.7012 | 893174.7012 | 893174.7012 | 893174.7012 | 893174.7012 | 893174.7012 | 893174.7012 | 893174.7012 | 893174.7012 | 893174.7012 | 893174.7012 | 893174.7012 | 893174.7012 | 893174.7012 | 893174.7012 | 893174.7012 | 893174.7012 | 893174.7012 | 893174.7012 | 893174.7012 | 893174.7012 | 893174.7012 | 893174.7012 | 893174.7012 | 893174.7012 | 893174.7012 | 893174.7012 | 893174.7012 | 893174.7012 | 893174.7012 | 893174.7012 | 893174.7012 | 893174.7012 | 893174.7012 | 893174.7012 | 893174.7012 | 893174.7012 | 893174.7012
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
