Froster2406/BAT2024/Dokumentation/measurements/Microphone/BAT_Mikrofon-Sinus-Offset.xlsx

94dBSPL
-63 | -95 | -123 | -147 | -166 | -180 | -188 | -191 | -188 | -180 | -167 | -148 | -125 | -97 | -66 | -30 | 8 | 49 | 91 | 135 | 179 | 223 | 265 | 306 | 345 | 381 | 413 | 441 | 465 | 484 | 498 | 507 | 510 | 508 | 501 | 488 | 470 | 448 | 421 | 390 | 356 | 318 | 278 | 236 | 193 | 150 | 106 | 63 | 22 | -17 | -52 | -85 | -113 | -137 | -156 | -170 | -178 | -181 | -178
-72 | -105 | -134 | -158 | -177 | -191 | -200 | -204 | -202 | -194 | -182 | -164 | -141 | -114 | -83 | -48 | -10 | 31 | 73 | 116 | 160 | 204 | 247 | 288 | 327 | 363 | 396 | 425 | 449 | 468 | 483 | 492 | 496 | 495 | 488 | 476 | 459 | 437 | 411 | 380 | 346 | 309 | 269 | 227 | 184 | 140 | 96 | 54 | 13 | -27 | -63 | -96 | -125 | -149 | -169 | -183 | -192 | -195
827 | 860 | 889 | 914 | 934 | 950 | 959 | 964 | 964 | 957 | 946 | 930 | 908 | 883 | 852 | 819 | 781 | 742 | 700 | 656 | 612 | 568 | 524 | 482 | 442 | 405 | 371 | 340 | 315 | 294 | 278 | 267 | 262 | 262 | 268 | 280 | 296 | 317 | 343 | 374 | 407 | 444 | 484 | 525 | 568 | 612 | 656 | 698 | 740 | 780 | 816 | 849 | 878 | 903 | 923 | 939 | 949 | 953 | 953 | 947
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
