Froster2406/BAT2024/Dokumentation/measurements/Microphone/BAT_Weighting_Matlab.xlsx

Frequency (Hz);dB
1.0;119.99999999888821
41.078156312625254;55.45239773877725
81.15631262525051;43.57914399499386
121.23446893787576;36.42118593338018
161.31262525050101;30.999005289720806
201.39078156312627;26.312131373387416
241.46893787575152;21.96636161367339
281.5470941883768;17.85390718280468
321.62525050100203;13.978084682957899
361.7034068136273;10.356638301969472
401.78156312625254;6.991801387659695
441.8597194388778;3.8711557054114056
481.93787575150304;0.9747089267655211
522.0160320641282;-1.7197600571645357
562.0941883767536;-4.233831287974434
602.1723446893789;-6.587206002522067
642.2505010020041;-8.797335656433958
682.3286573146293;-10.879457145278337
722.4068136272546;-12.846793667705953
762.4849699398799;-14.710805067414041
802.5631262525051;-16.48143550661954
842.6412825651303;-18.167337639928334
882.7194388777556;-19.776067142937737
922.7975951903809;-21.314247949457055
962.8757515030061;-22.7877111211402
1002.9539078156313;-24.20161101507613
1043.0320641282565;-25.560522351353416
1083.110220440882;-26.868521403272783
1123.188376753507;-28.12925406528763
1163.2665330661323;-29.34599309794401
1203.3446893787577;-30.521686443939394
1243.422845691383;-31.658998165320295
1283.5010020040081;-32.760343266688984
1323.5791583166333;-33.82791743618517
1363.6573146292585;-34.863722546837224
1403.735470941884;-35.869588607882356
1443.8136272545091;-36.84719273203567
1483.8917835671343;-37.798075584739145
1523.9699398797597;-38.72365570046787
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
19719.452905811624;-127.67398870588474
19759.53106212425;-127.74453045194795
19799.609218436875;-127.81492926341264
19839.6873747495;-127.8851857183476
19879.765531062127;-127.95530039132196
19919.843687374752;-128.0252738534332
19959.921843687378;-128.09510667233522
20000.0;-128.16479941226592
