Froster2406/BAT2024/Dokumentation/measurements/Microphone/BAT_Frequenzmessung_Geraet.csv

Frequenz | MEMS_Z_2 | MEMS_C_2 | MEMS_A_2 | MEMS_Z | MEMS_C | MEMS_A | MEMS_A_3 | Faktor_C | Faktor_A | Offset | Kurve_C | Kurve_A
0 | 0 | 0 | 0 | 69.5 | 69.5 | 69.5 | 0 | 0 | 0 | 80 | 0 | 0
10 | 0 | 0 | 0 | 69.6 | 69.7 | 69.7 | 0 | 14.3 | 70.4 | 80 | 65.7 | 9.6
20 | 0 | 0 | 0 | 69.7 | 69.8 | 69.8 | 0 | 6.2 | 50.4 | 80 | 73.8 | 29.6
30 | 0 | 0 | 0 | 70 | 69.5 | 69.5 | 0 | 3.3 | 40.6 | 80 | 76.7 | 39.4
40 | 0 | 0 | 0 | 70.2 | 69 | 69 | 0 | 2 | 34.5 | 80 | 78 | 45.5
50 | 69.2 | 67.9 | 62 | 70.6 | 69.3 | 69.5 | 38.9 | 1.3 | 30.3 | 80 | 78.7 | 49.7
60 | 73.5 | 72.6 | 67.1 | 71.3 | 70.4 | 69.7 | 46.5 | 0.9 | 27 | 80 | 79.1 | 53
70 | 77.3 | 76.6 | 67.3 | 74.1 | 73.4 | 69.8 | 52.8 | 0.7 | 24.5 | 80 | 79.3 | 55.5
80 | 82.4 | 81.9 | 67.4 | 78.7 | 78.2 | 69.5 | 60 | 0.5 | 22.4 | 80 | 79.5 | 57.6
90 | 84 | 83.6 | 67.3 | 77.8 | 77.4 | 69 | 63.4 | 0.4 | 20.6 | 80 | 79.6 | 59.4
100 | 81.3 | 81 | 67.9 | 78.3 | 78 | 69.5 | 62.2 | 0.3 | 19.1 | 80 | 79.7 | 60.9
200 | 73.9 | 73.9 | 67.7 | 77.6 | 77.6 | 69.3 | 63.1 | 0 | 10.8 | 80 | 80 | 69.2
300 | 74.6 | 74.6 | 67.5 | 76.4 | 76.4 | 69.3 | 67.5 | 0 | 7.1 | 80 | 80 | 72.9
400 | 74.8 | 74.8 | 70 | 76.3 | 76.3 | 71.5 | 70 | 0 | 4.8 | 80 | 80 | 75.2
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
