Froster2406/BAT2024/Dokumentation/measurements/Microphone/BAT_Frequenzmessung_Referenz.csv

Frequenz | MEMS_2 | Referenz_Z_2 | Referenz_C_2 | Referenz_A_2 | MEMS | Referenz_Z | Referenz_C | Referenz_A
0 | 0 | 0 | 0 | 0 | 69.5 | 36.2 | 33.1 | 20.8
10 | 0 | 0 | 0 | 0 | 69.6 | 35.2 | 33.3 | 28.4
20 | 0 | 0 | 0 | 0 | 69.7 | 41.9 | 37.6 | 28.6
30 | 0 | 0 | 0 | 0 | 70 | 57.7 | 55.5 | 33.3
40 | 0 | 0 | 0 | 0 | 70.2 | 66 | 64 | 33.3
50 | 69.2 | 69.3 | 68 | 39.7 | 70.6 | 68.1 | 66.8 | 38.4
60 | 73.5 | 73.3 | 72.3 | 46.3 | 71.3 | 72.9 | 72 | 46
70 | 77.3 | 77.9 | 77.3 | 53.5 | 74.1 | 78.3 | 77.7 | 53.9
80 | 82.4 | 83.4 | 82.9 | 61 | 78.7 | 84.2 | 83.7 | 61.8
90 | 84 | 84.5 | 84.2 | 63.9 | 77.8 | 84.4 | 84 | 63.8
100 | 81.3 | 82.1 | 81.1 | 63 | 78.3 | 81.5 | 81.2 | 62.3
200 | 73.9 | 73.9 | 73.8 | 63 | 77.6 | 74.7 | 74.7 | 63.9
300 | 74.6 | 74.1 | 74 | 67 | 76.4 | 74.6 | 74.6 | 67.5
400 | 74.8 | 74.5 | 74.5 | 69.7 | 76.3 | 75.6 | 75.8 | 70.9
500 | 75.2 | 75.5 | 75.5 | 72.2 | 76.6 | 76.8 | 76.6 | 73.4
600 | 78.8 | 78.6 | 78.6 | 76.4 | 77.7 | 78.7 | 78.8 | 76.6
700 | 79.2 | 78.3 | 78.3 | 76.9 | 79.4 | 80.8 | 80.8 | 79.4
800 | 80.1 | 80.1 | 80.2 | 79.3 | 79.3 | 79.5 | 79.5 | 78.7
900 | 80 | 79.7 | 79.7 | 79.4 | 79.8 | 80.6 | 80.6 | 80.2
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
