Froster2406/BAT2024/Dokumentation/measurements/Microphone/BAT_Rauschboden_Speisung.csv

Sample | usb | batterie | usb_batterie
1 | 193044 | 191506 | 192023
2 | 193066 | 191485 | 191908
3 | 193256 | 191521 | 191957
4 | 193114 | 191393 | 191873
5 | 193114 | 191455 | 191936
6 | 193074 | 191410 | 191917
7 | 193061 | 191409 | 192012
8 | 193043 | 191349 | 191981
9 | 193071 | 191413 | 192006
10 | 193097 | 191426 | 191871
11 | 193017 | 191518 | 191803
12 | 192969 | 191403 | 191815
13 | 193019 | 191386 | 191952
14 | 193070 | 191411 | 191923
15 | 192989 | 191375 | 191954
16 | 193037 | 191413 | 191917
17 | 193026 | 191480 | 191988
18 | 192998 | 191408 | 191932
19 | 192973 | 191347 | 191934
20 | 192918 | 191429 | 191848
21 | 192936 | 191299 | 191859
22 | 192997 | 191418 | 191919
23 | 192997 | 191381 | 191839
24 | 192970 | 191401 | 191898
25 | 193017 | 191499 | 191845
26 | 192997 | 191464 | 191879
27 | 193076 | 191413 | 191938
28 | 193215 | 191403 | 191966
29 | 193164 | 191380 | 191918
30 | 193163 | 191346 | 191740
31 | 193106 | 191443 | 191699
32 | 193124 | 191462 | 191757
33 | 193056 | 191367 | 191739
34 | 193086 | 191379 | 191833
35 | 193026 | 191413 | 191869
36 | 193105 | 191461 | 191778
37 | 193075 | 191439 | 191810
38 | 193123 | 191537 | 191914
39 | 193116 | 191414 | 191923
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
