Froster2406/BAT2024/Dokumentation/measurements/Power/BAT_Leistungsaufnahme_komplett.png

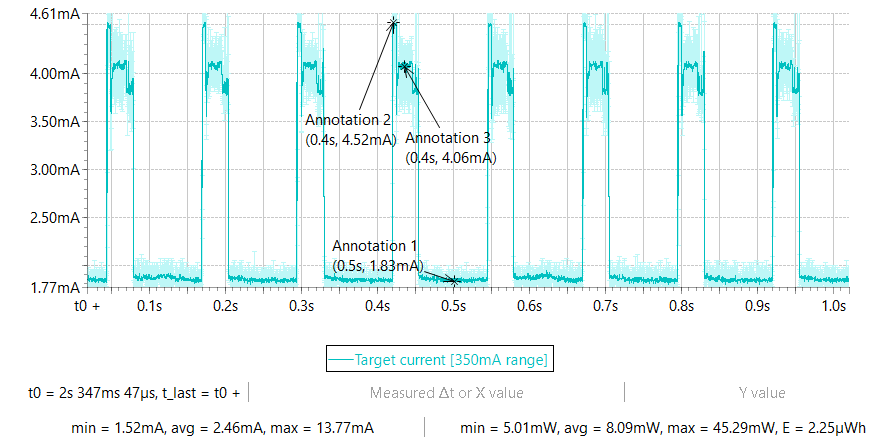
Dokumentation/measurements/Power/BAT_Leistungsaufnahme_komplett.png
