Froster2406/BAT2024/Dokumentation/measurements/Power/EEPROM.png

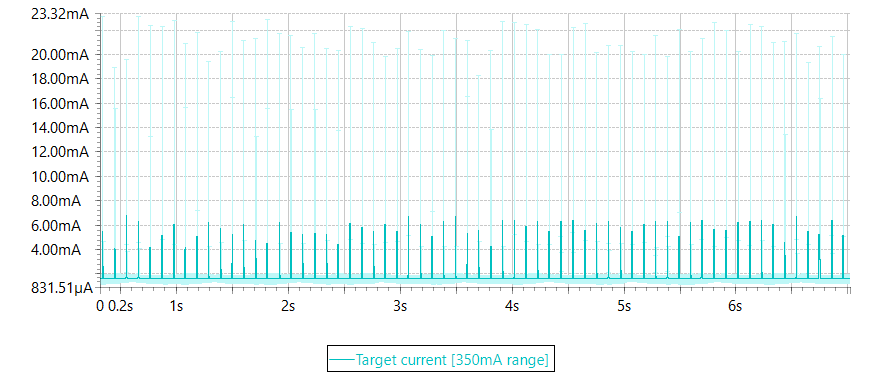
Dokumentation/measurements/Power/EEPROM.png
