Froster2406/BAT2024/Hardware/BAT_Schematic_V1-2.pdf

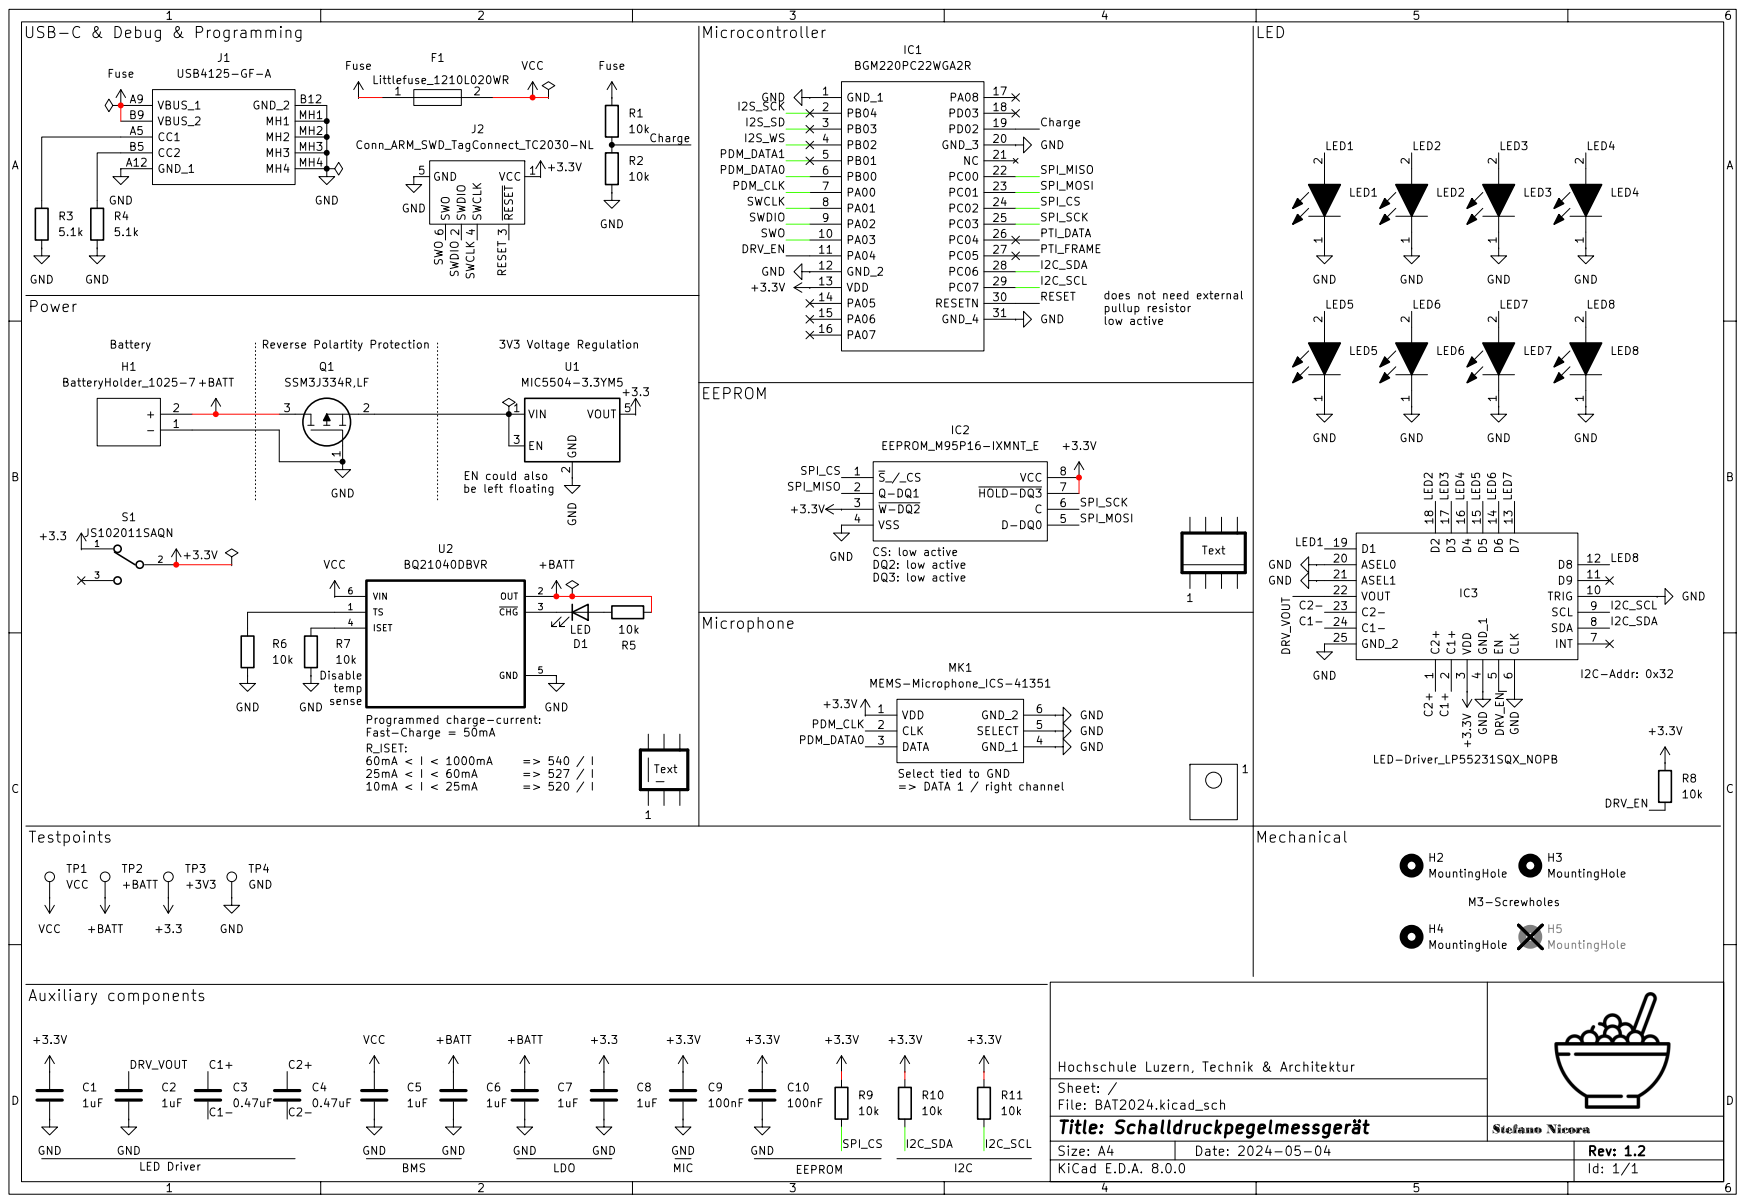
[picture p123: page 1]
