Froster2406/BAT2024/Hardware/BAT_Testlayout_back_V1-3.pdf

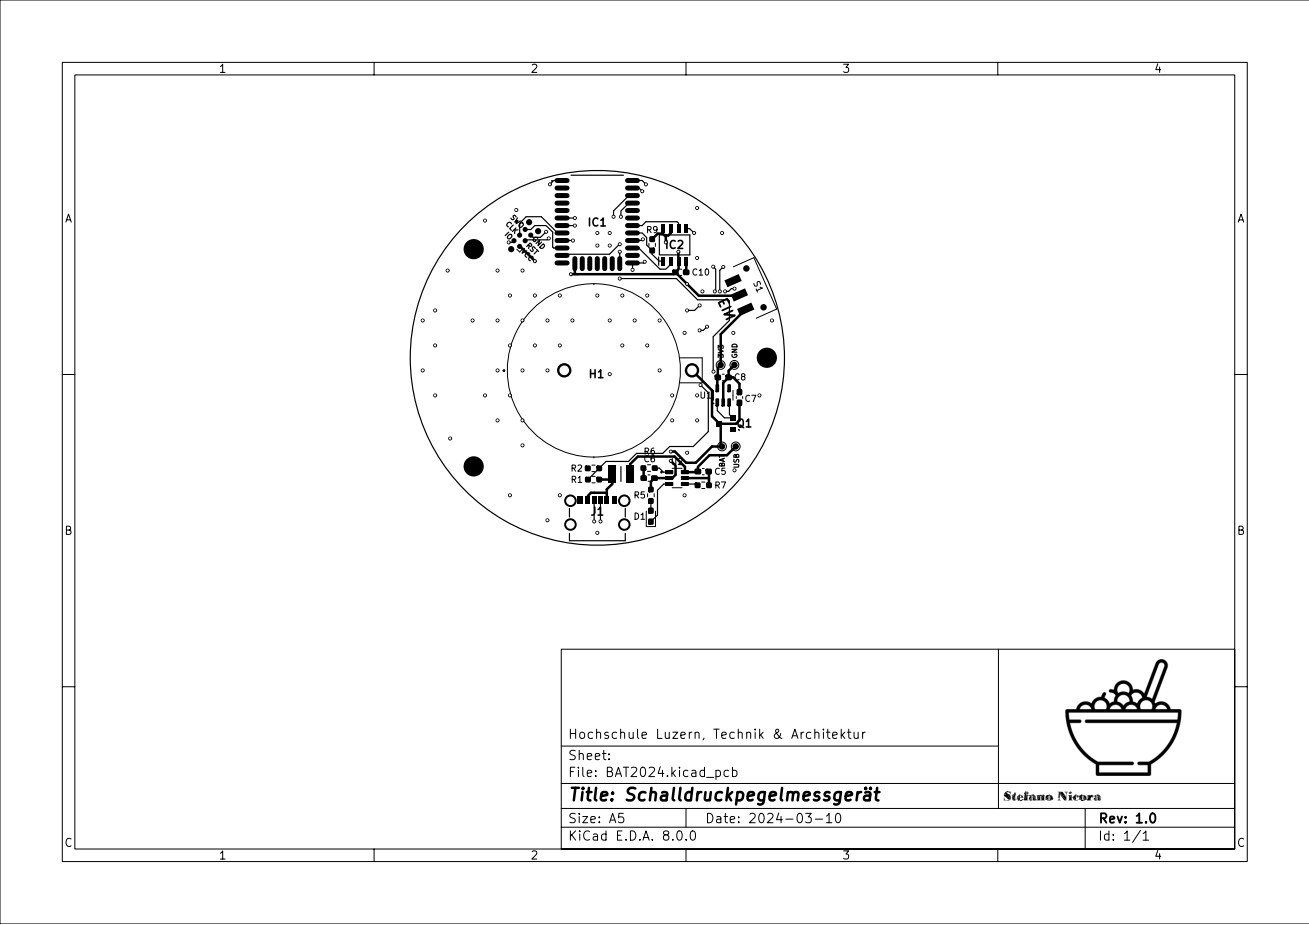
[picture p124: page 1]
