Froster2406/BAT2024/Hardware/BAT_Testlayout_front_V1-3.pdf

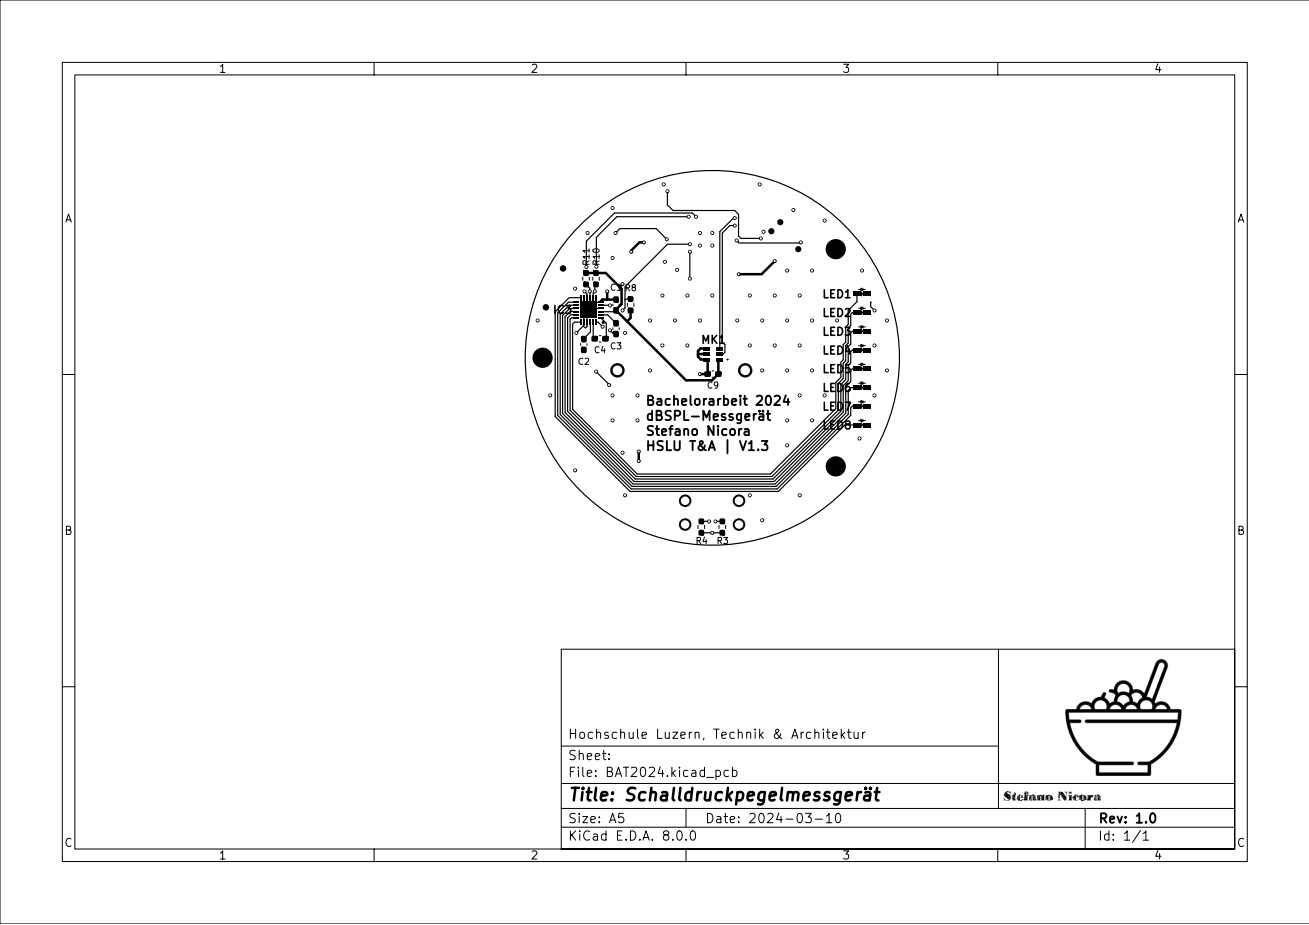
[picture p125: page 1]
