Froster2406/BAT2024/Hardware/BAT_Schematic_V1-0.pdf

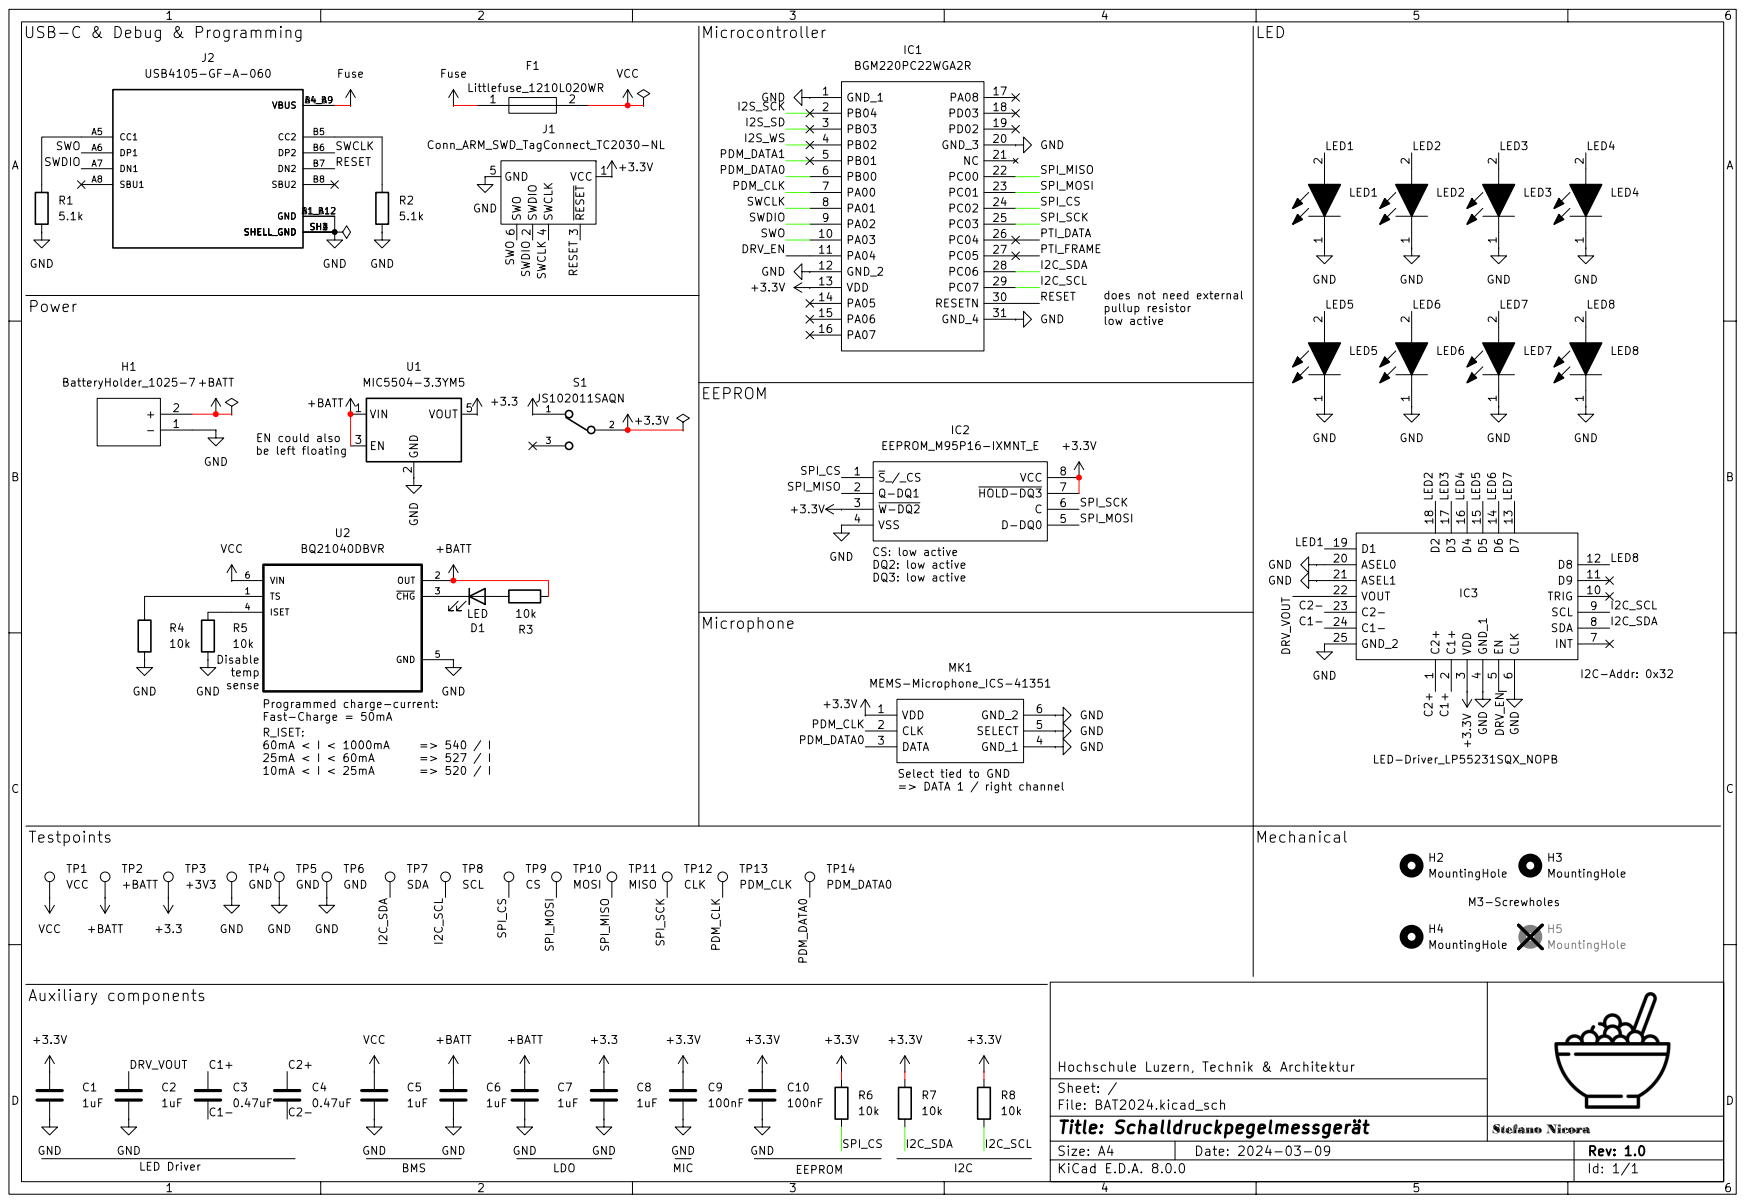
[picture p126: page 1]
