Froster2406/BAT2024/Hardware/BAT_Testlayout_back_V1-0.pdf

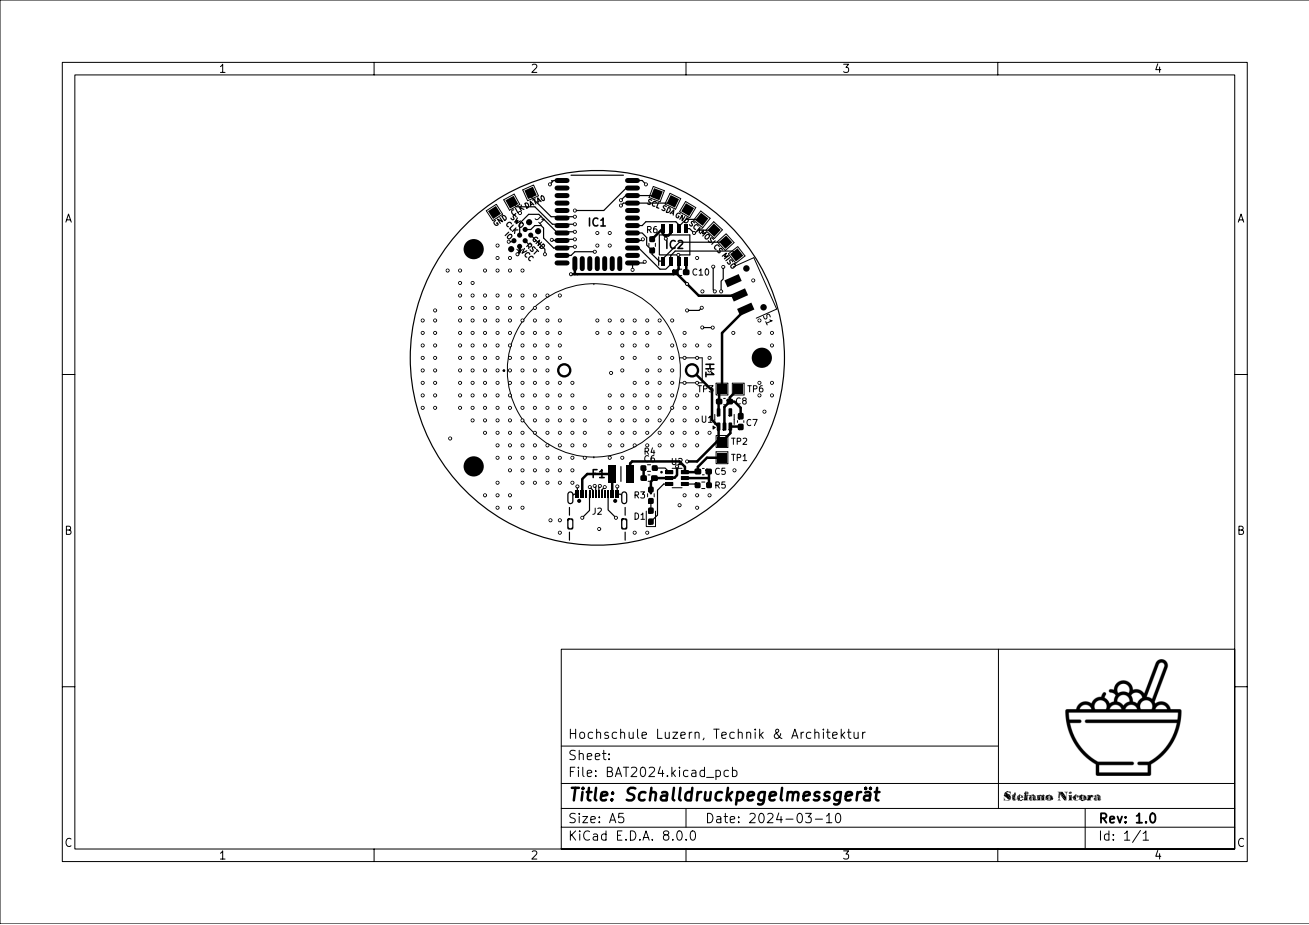
[picture p127: page 1]
