Froster2406/BAT2024/Hardware/BAT_Testlayout_front_V1-0.pdf

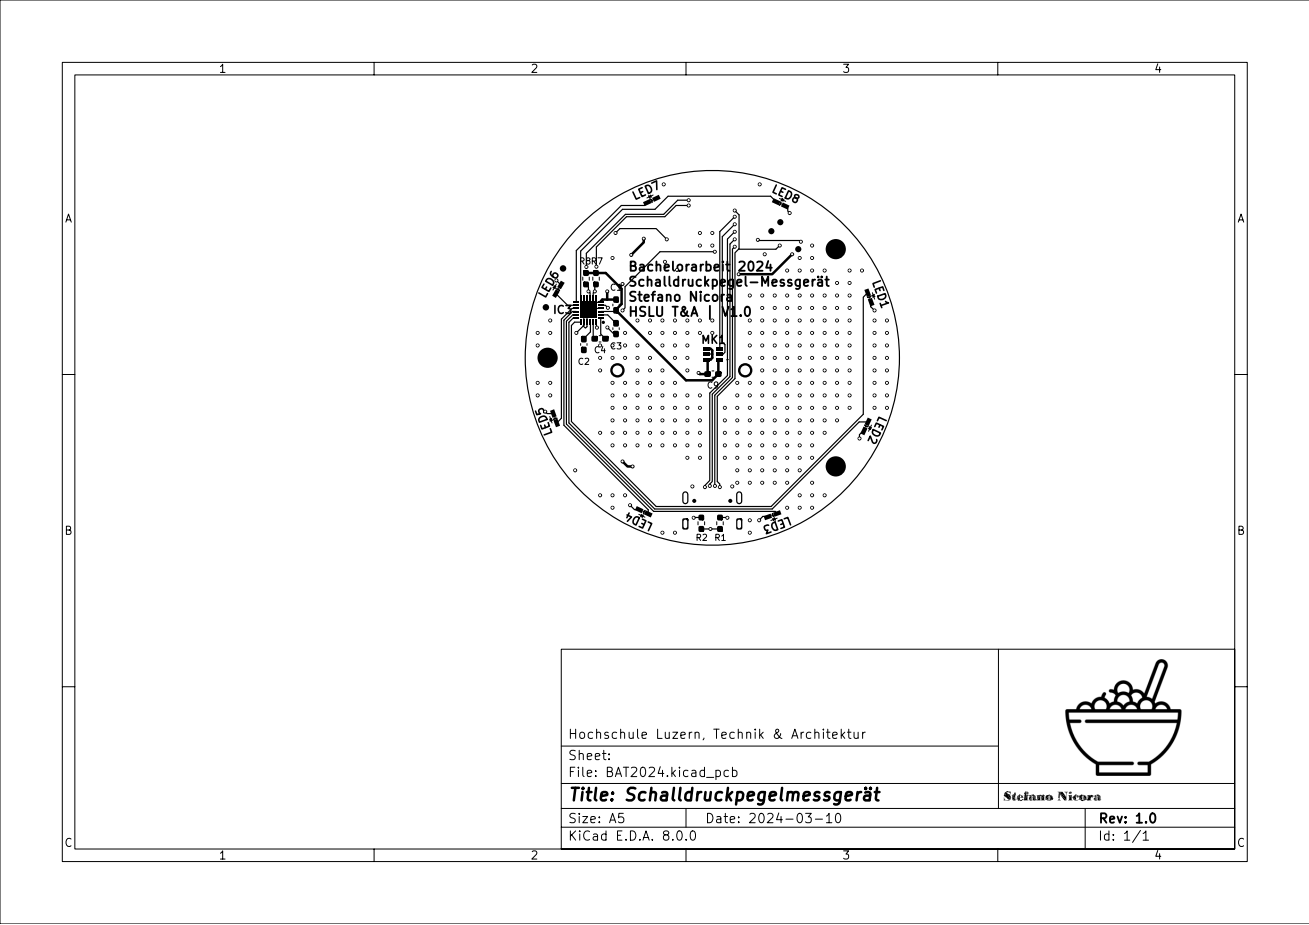
[picture p128: page 1]
