Froster2406/BAT2024/Hardware/BAT2024.kicad_pcb

## KiCad design Hardware/BAT2024.kicad_pcb (2024-05-19)

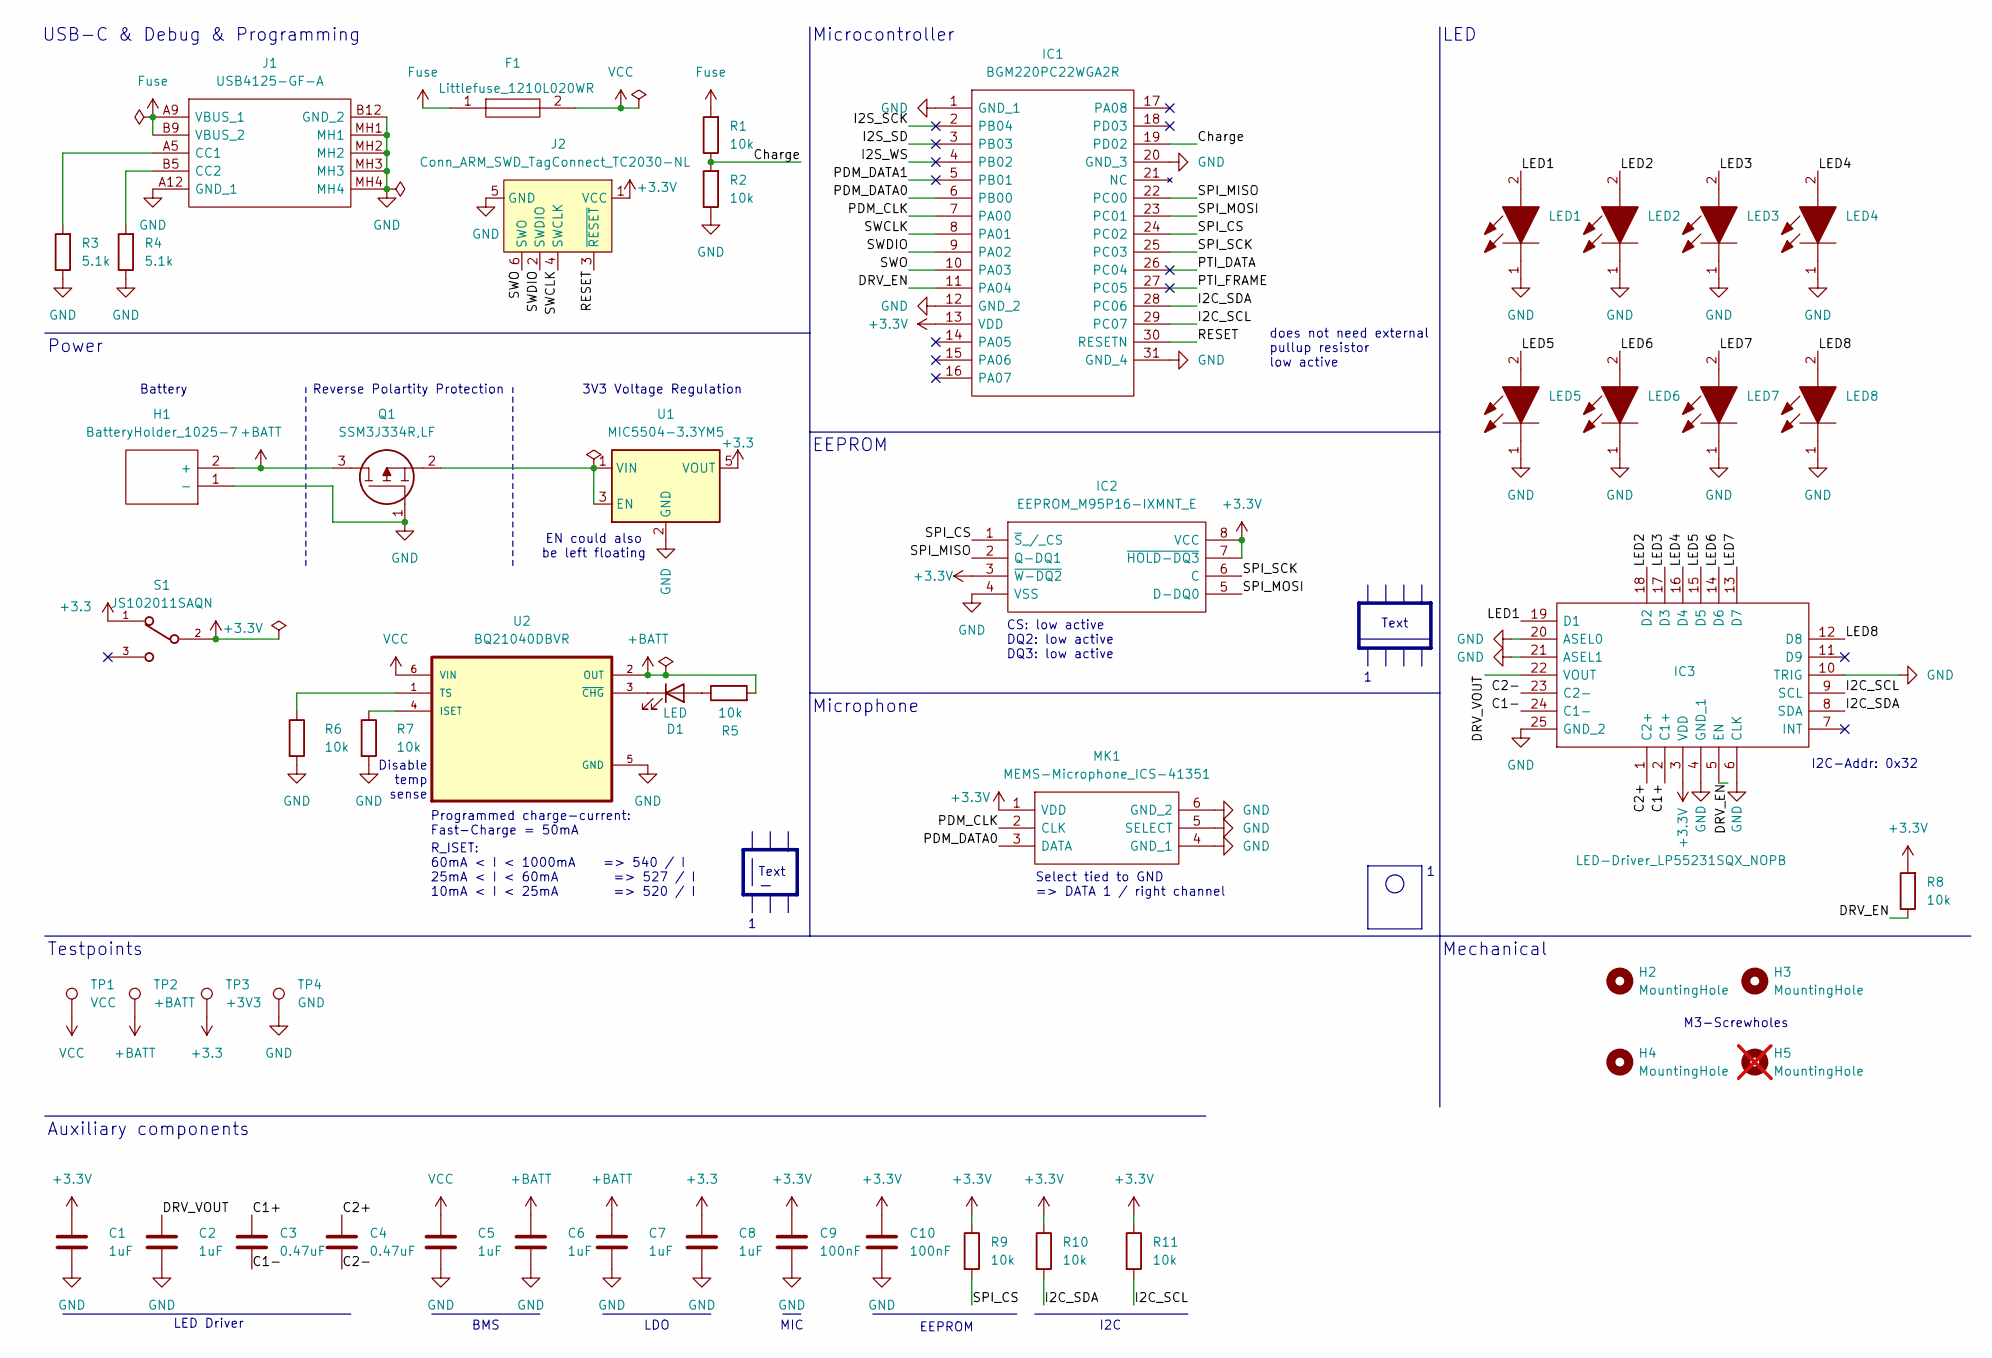
[picture p129: schematic BAT2024.kicad_sch, Schalldruckpegelmessgerät]

Parts:
C1, C2, C5, C6, C7, C8: 1uF; C_0603_1608Metric_Pad1.08x0.95mm_HandSolder
C3, C4: 0.47uF; C_0603_1608Metric_Pad1.08x0.95mm_HandSolder
C9, C10: 100nF; C_0603_1608Metric_Pad1.08x0.95mm_HandSolder
D1: LED; LED_0603_1608Metric_Pad1.05x0.95mm_HandSolder
F1: Littlefuse_1210L020WR; Littlefuse_FUSC3226X100N; Mouser Part Number 576-1210L020WR
H1: BatteryHolder_1025-7; BatteryHolder_10257; Mouser Part Number 534-1025-7
H2, H3, H4: MountingHole; MountingHole_3.2mm_M3
H5: MountingHole; MountingHole_3.2mm_M3; not fitted
IC1: BGM220PC22WGA2R; Mouser Part Number 634-BGM220PC22WGA2R
IC2: EEPROM_M95P16-IXMNT_E; EEPROM_SOIC127P600X175-8L; Mouser Part Number 511-M95P16-IXMNT/E
IC3: LED-Driver_LP55231SQX_NOPB; LED-Driver-QFN50P400X400X80-25N; Mouser Part Number 595-LP55231SQX/NOPB
J1: USB4125-GF-A; USB4125GFA; Mouser Part Number 640-USB4125-GF-A
J2: Conn_ARM_SWD_TagConnect_TC2030-NL; Tag-Connect_TC2030-IDC-NL_2x03_P1.27mm_Vertical
LED1, LED2, LED3, LED4, LED5, LED6, LED7, LED8: LED_XZCM2CRK53WA-8VF; LEDM168X110N; Manufacturer_Part_Number XZCM2CRK53WA-8VF
MK1: MEMS-Microphone_ICS-41351; MEMS-Mikrofon_ICS41351; Mouser Part Number 410-ICS-41351
Q1: SSM3J334R,LF; SSM3J334RLF; Mouser Part Number 757-SSM3J334RLF
R1, R2, R5, R6, R7, R8, R9, R10, R11: 10k; R_0603_1608Metric_Pad0.98x0.95mm_HandSolder
R3, R4: 5.1k; R_0603_1608Metric_Pad0.98x0.95mm_HandSolder
S1: JS102011SAQN; C-K_Switch_JS102011SAQN; DigiKey_Part_Number 401-1999-2-ND
TP1: VCC; TestPoint_Pad_D1.0mm
TP2: +BATT; TestPoint_Pad_D1.0mm
TP3: +3V3; TestPoint_Pad_D1.0mm
TP4: GND; TestPoint_Pad_D1.0mm
U1: MIC5504-3.3YM5; SOT-23-5
U2: BQ21040DBVR; BatteryManagement_SOT95P280X145-6N

Connections:
+3.3: C8.1, S1.1, TP3.1, U1.5 (VOUT)
+3.3V: C1.1, C9.1, C10.1, IC1.13 (VDD), IC2.3 (~W-DQ2), IC2.7 (~HOLD-DQ3), IC2.8 (VCC), IC3.3 (VDD), J2.1 (VCC), MK1.1 (VDD), R8.2, R9.1, R10.1, R11.1, S1.2
+BATT: C6.1, C7.1, H1.2 (+), Q1.3, R5.2, TP2.1, U2.2 (OUT)
/C1+: C3.1, IC3.2 (C1+)
/C1-: C3.2, IC3.24 (C1-)
/C2+: C4.1, IC3.1 (C2+)
/C2-: C4.2, IC3.23 (C2-)
/Charge: IC1.19 (PD02), R1.1, R2.2
/DRV_EN: IC1.11 (PA04), IC3.5 (EN), R8.1
/DRV_VOUT: C2.1, IC3.22 (VOUT)
/I2C_SCL: IC1.29 (PC07), IC3.9 (SCL), R11.2
/I2C_SDA: IC1.28 (PC06), IC3.8 (SDA), R10.2
/I2S_SCK: IC1.2 (PB04)
/I2S_SD: IC1.3 (PB03)
/I2S_WS: IC1.4 (PB02)
/LED1: IC3.19 (D1), LED1.2
/LED2: IC3.18 (D2), LED2.2
/LED3: IC3.17 (D3), LED3.2
/LED4: IC3.16 (D4), LED4.2
/LED5: IC3.15 (D5), LED5.2
/LED6: IC3.14 (D6), LED6.2
/LED7: IC3.13 (D7), LED7.2
/LED8: IC3.12 (D8), LED8.2
/PDM_CLK: IC1.7 (PA00), MK1.2 (CLK)
/PDM_DATA0: IC1.6 (PB00), MK1.3 (DATA)
/PDM_DATA1: IC1.5 (PB01)
/PTI_DATA: IC1.26 (PC04)
/PTI_FRAME: IC1.27 (PC05)
/RESET: IC1.30 (RESETN), J2.3 (~RESET)
/SPI_CS: IC1.24 (PC02), IC2.1 (~S_/_CS), R9.2
/SPI_MISO: IC1.22 (PC00), IC2.2 (Q-DQ1)
/SPI_MOSI: IC1.23 (PC01), IC2.5 (D-DQ0)
/SPI_SCK: IC1.25 (PC03), IC2.6 (C)
/SWCLK: IC1.8 (PA01), J2.4 (SWCLK)
/SWDIO: IC1.9 (PA02), J2.2 (SWDIO)
/SWO: IC1.10 (PA03), J2.6 (SWO)
Fuse: F1.1, J1.A9 (VBUS_1), J1.B9 (VBUS_2), R1.2
GND: C1.2, C2.2, C5.2, C6.2, C7.2, C8.2, C9.2, C10.2, H1.1 (-), IC1.1 (GND_1), IC1.12 (GND_2), IC1.20 (GND_3), IC1.31 (GND_4), IC2.4 (VSS), IC3.4 (GND_1), IC3.6 (CLK), IC3.10 (TRIG), IC3.20 (ASEL0), IC3.21 (ASEL1), IC3.25 (GND_2), J1.A12 (GND_1), J1.B12 (GND_2), J1.MH1, J1.MH2, J1.MH3, J1.MH4, J2.5 (GND), LED1.1, LED2.1, LED3.1, LED4.1, LED5.1, LED6.1, LED7.1, LED8.1, MK1.4 (GND_1), MK1.5 (SELECT), MK1.6 (GND_2), Q1.1, R2.1, R3.1, R4.1, R6.2, R7.2, TP4.1, U1.2 (GND), U2.5 (GND)
unnamed: D1.2 (A), R5.1
unnamed: D1.1 (K), U2.3 (~CHG)
unnamed: J1.A5 (CC1), R3.2
unnamed: J1.B5 (CC2), R4.2
unnamed: Q1.2, U1.1 (VIN), U1.3 (EN)
unnamed: R7.1, U2.4 (ISET)
unnamed: R6.1, U2.1 (TS)
VCC: C5.1, F1.2, TP1.1, U2.6 (VIN)

Notes on the sheet:
Programmed charge-current: Fast-Charge = 50mA
Select tied to GND => DATA 1 / right channel
I2C
Disable temp sense
Text
Reverse Polartity Protection
MIC
LDO
Power
Testpoints
EEPROM
Microphone
does not need external pullup resistor low active
BMS
M3-Screwholes
CS: low active DQ2: low active DQ3: low active
LED Driver
Mechanical
EN could also be left floating
Microcontroller
I2C-Addr: 0x32
LED
USB-C & Debug & Programming
Battery
3V3 Voltage Regulation
R_ISET: 60mA < I < 1000mA => 540 / I 25mA < I < 60mA => 527 / I 10mA < I < 25mA => 520 / I
Auxiliary components

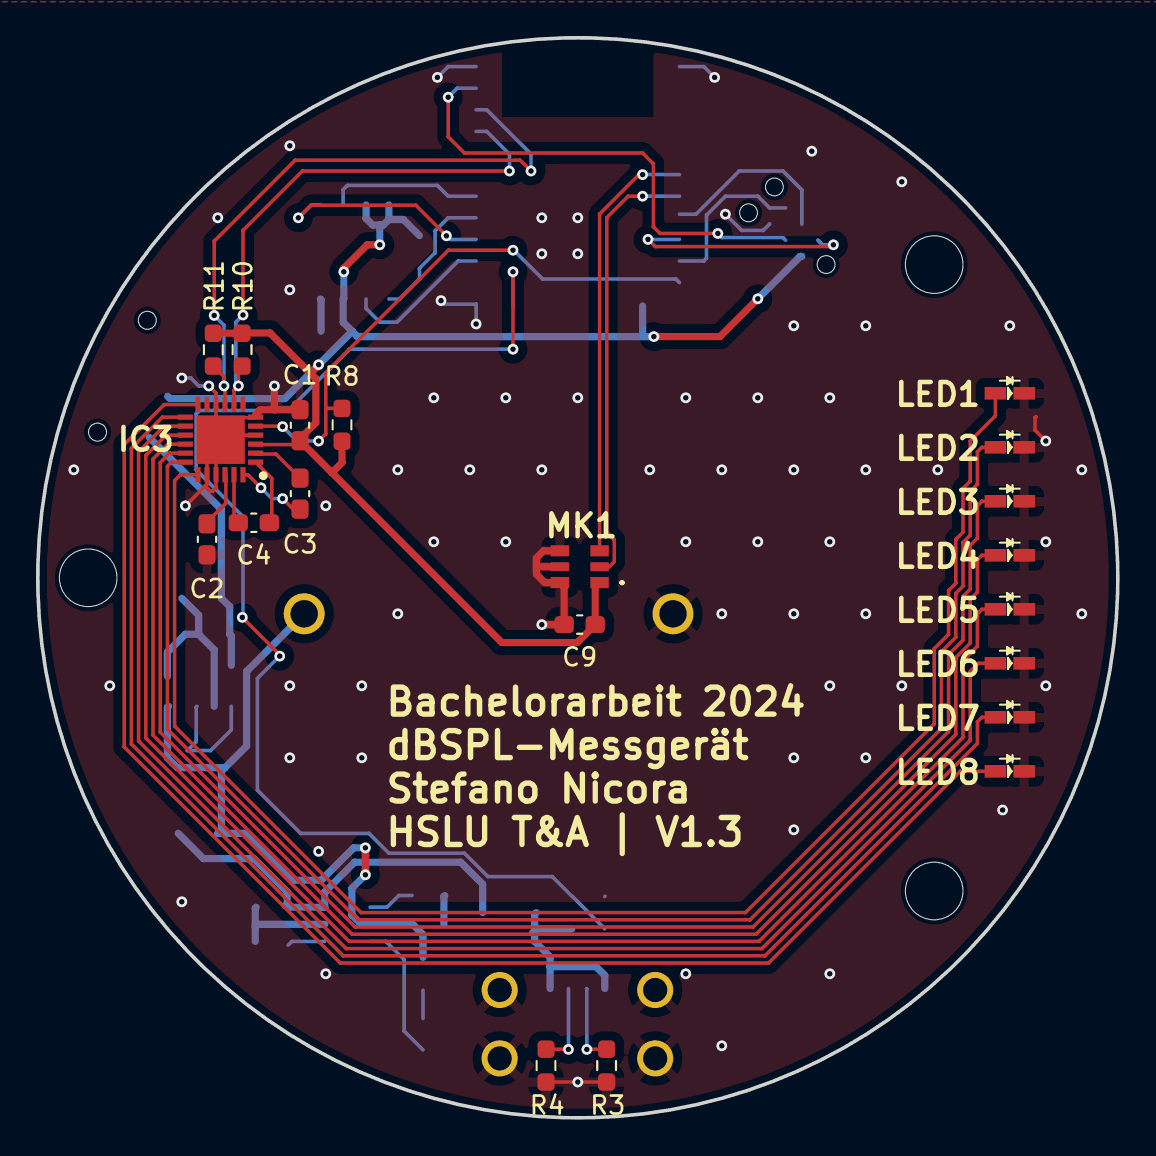
[picture p130: board BAT2024.kicad_pcb from above]

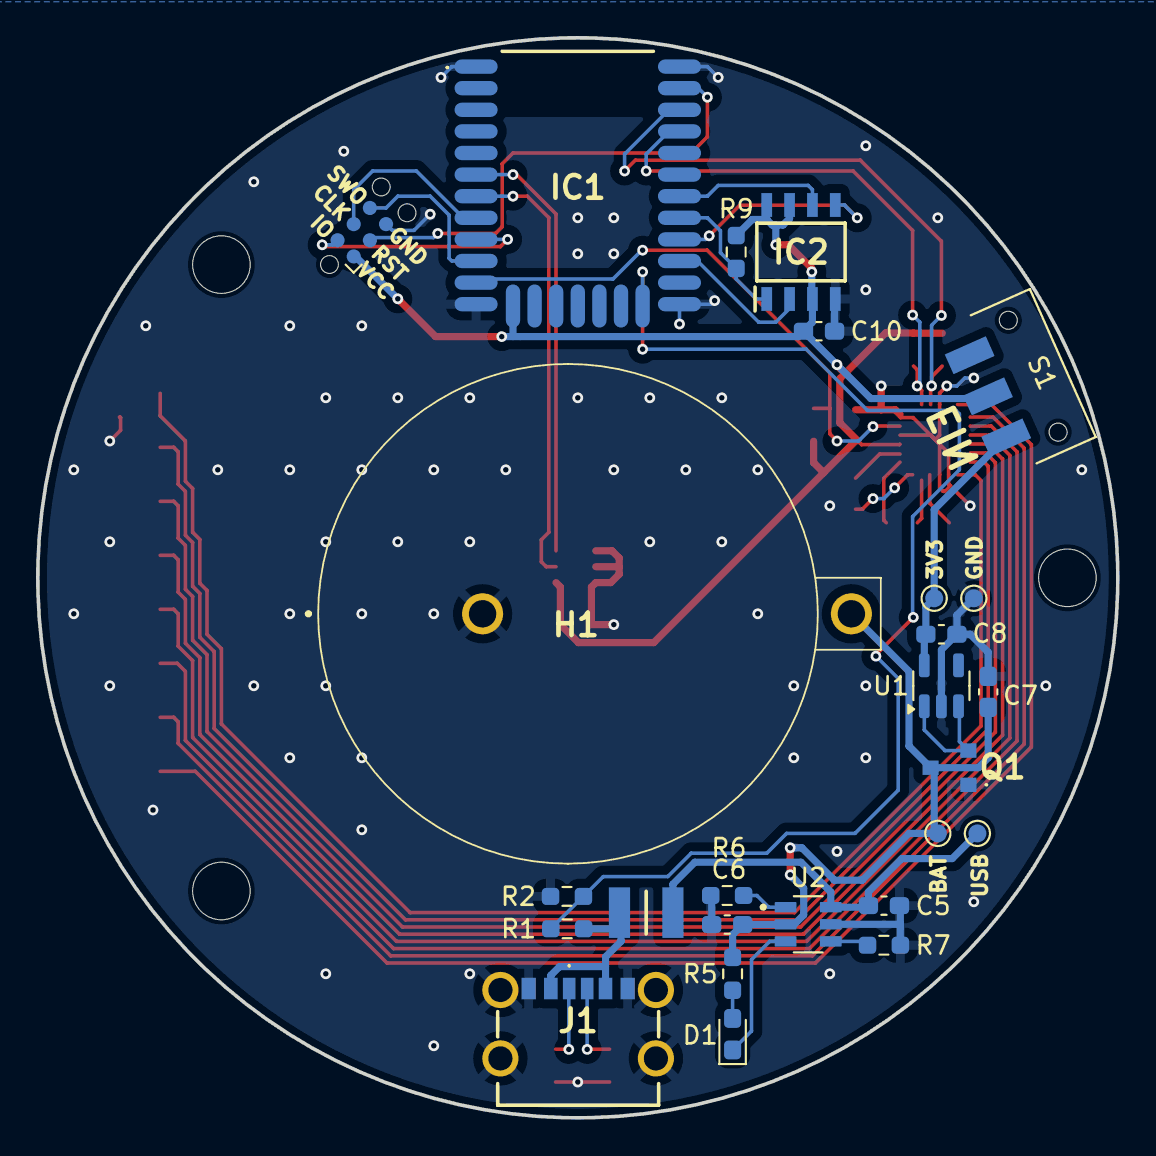
[picture p131: board BAT2024.kicad_pcb from below]

Board: 2 copper layers, 60.0 x 60.0 mm, 49 parts (29 on the bottom side), 40 nets.
