Froster2406/BAT2024/Hardware/BAT_SWD-Adapterboard/BAT_SWD-Adapterboard.kicad_pcb

## KiCad design Hardware/BAT_SWD-Adapterboard/BAT_SWD-Adapterboard.kicad_pcb (2024-03-24)

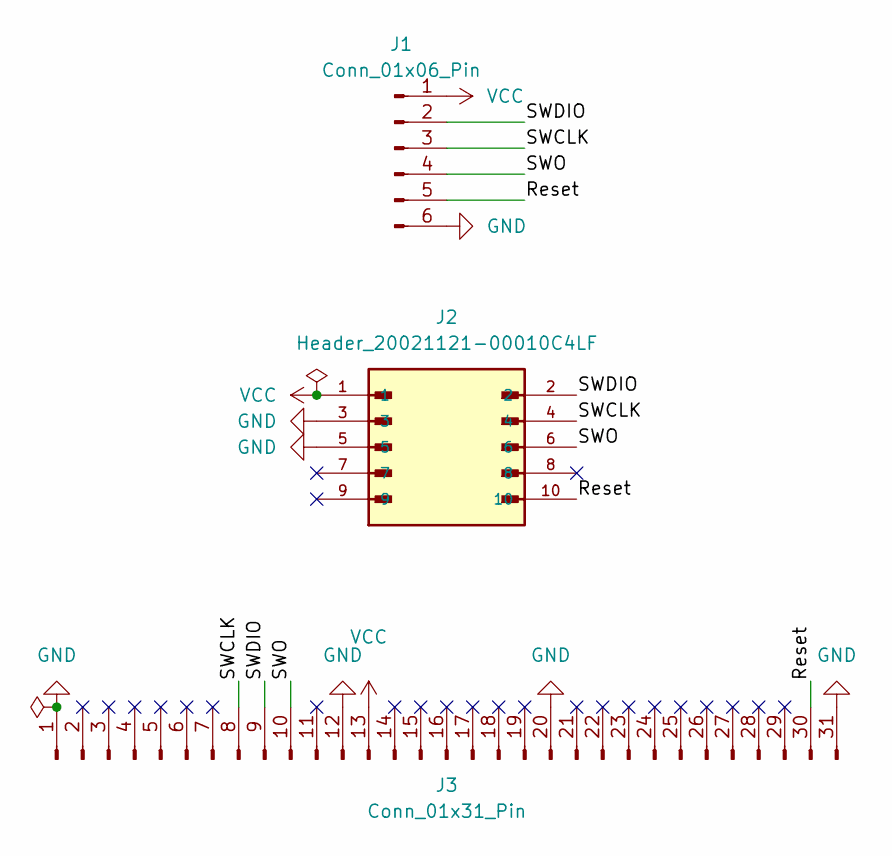
[picture p132: schematic BAT_SWD-Adapterboard.kicad_sch]

Parts:
J1: Conn_01x06_Pin; PinHeader_2x03_P2.54mm_Vertical
J2: Header_20021121-00010C4LF; AMPHENOL_20021121-00010C4LF; PARTREV R
J3: Conn_01x31_Pin; BGM220PC22WGA2R_castellated-holes

Connections:
/Reset: J1.5, J2.10, J3.30
/SWCLK: J1.3, J2.4, J3.8
/SWDIO: J1.2, J2.2, J3.9
/SWO: J1.4, J2.6, J3.10
GND: J1.6, J2.3, J2.5, J3.1, J3.12, J3.20, J3.31
VCC: J1.1, J2.1, J3.13

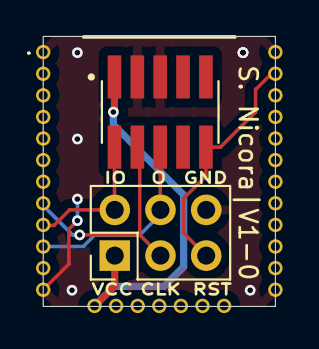
[picture p133: board BAT_SWD-Adapterboard.kicad_pcb from above]

Board: 2 copper layers, 12.9 x 15.0 mm, 3 parts (0 on the bottom side), 6 nets.
