Froster2406/BAT2024/Hardware/BAT_Breakout/BAT_Breakout.kicad_pcb

## KiCad design Hardware/BAT_Breakout/BAT_Breakout.kicad_pcb (2024-03-13)

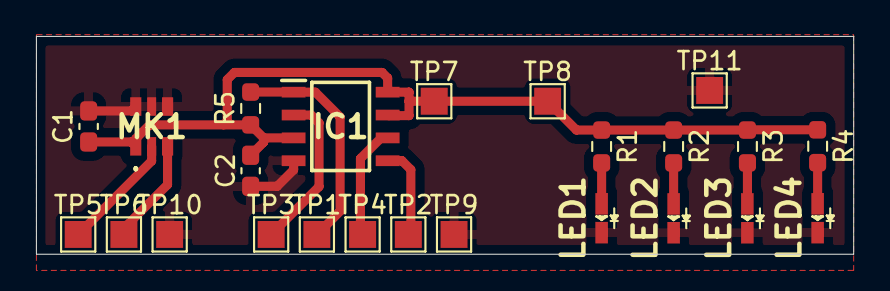
[picture p134: board BAT_Breakout.kicad_pcb from above]

Board: 2 copper layers, 45.4 x 12.1 mm, 24 parts (0 on the bottom side), 12 nets.

Parts:
C1, C2: 100nF; C_0603_1608Metric_Pad1.08x0.95mm_HandSolder
IC1: EEPROM_M95P16-IXMNT_E; EEPROM_SOIC127P600X175-8L
LED1, LED2, LED3, LED4: LED_XZCM2CRK53WA-8VF; LEDM168X110N
MK1: MEMS-Microphone_ICS-41351; MEMS-Mikrofon_ICS41351
R1, R2, R3, R4: R; R_0603_1608Metric_Pad0.98x0.95mm_HandSolder
R5: 10k; R_0603_1608Metric_Pad0.98x0.95mm_HandSolder
TP1: CS; TestPoint_Pad_1.5x1.5mm
TP2: MOSI; TestPoint_Pad_1.5x1.5mm
TP3: MISO; TestPoint_Pad_1.5x1.5mm
TP4: CLK; TestPoint_Pad_1.5x1.5mm
TP5: PDM_CLK; TestPoint_Pad_1.5x1.5mm
TP6: PDM_DATA0; TestPoint_Pad_1.5x1.5mm
TP7, TP8: +3V3; TestPoint_Pad_1.5x1.5mm
TP9, TP10, TP11: GND; TestPoint_Pad_1.5x1.5mm

Connections:
+3.3V: C1.1, C2.1, IC1.3 (~W-DQ2), IC1.7 (~HOLD-DQ3), IC1.8 (VCC), MK1.1 (VDD), R1.1, R2.1, R3.1, R4.1, R5.1, TP7.1, TP8.1
/PDM_CLK: MK1.2 (CLK), TP5.1
/PDM_DATA0: MK1.3 (DATA), TP6.1
/SPI_CS: IC1.1 (~S_/_CS), R5.2, TP1.1
/SPI_MISO: IC1.2 (Q-DQ1), TP3.1
/SPI_MOSI: IC1.5 (D-DQ0), TP2.1
/SPI_SCK: IC1.6 (C), TP4.1
GND: C1.2, C2.2, IC1.4 (VSS), LED1.1, LED2.1, LED3.1, LED4.1, MK1.4 (GND_1), MK1.5 (SELECT), MK1.6 (GND_2), TP9.1, TP10.1, TP11.1
unnamed: LED1.2, R1.2
unnamed: LED2.2, R2.2
unnamed: LED3.2, R3.2
unnamed: LED4.2, R4.2
