Froster2406/BAT2024/Software/custom/BAT_LOGGING.h

/*
 * BAT_LOGGING.c
 *
 *  Created on: 16.03.2024
 *      Author: Stefano Nicora
 */

#ifndef CUSTOM_BAT_LOGGING_C_
#define CUSTOM_BAT_LOGGING_C_

#include <string.h>

void BAT_LOGGING_generateLogString(char* outputStr, char* timestamp, char *dBSPL);

#endif /* CUSTOM_BAT_LOGGING_C_ */
