Froster2406/BAT2024/(commit log)

2024-02-27 Add table microcontroller-vergleich
    [BAT_Vergleich-Mikrocontroller.xlsx]
2024-02-28 finalized comparison table for microcontroller
    [BAT_Vergleich-Mikrocontroller.xlsx]
2024-03-04 Add new images and tables for documentation purpose
    [BAT_BLE_vs_Bluetooth_Classic.xlsx, BAT_Berechnung_Energiebedarf_System.xlsx, BAT_Berechnung_Speicherbedarf_Logging.xlsx, BAT_Vergleich-LED.xlsx, BAT_Vergleich-Mikrofone.xlsx]
2024-03-04 Add initial files for PCB design
    [BAT2024.kicad_pcb, BAT2024.kicad_sch]
2024-03-05 Add PDF-Files for PCB V1.0
2024-03-05 Add material list for PCB V1.0
    [BAT_Materialliste.xlsx]
2024-03-05 Created basic library for PCB-Design
2024-03-05 Updated PCB-Library with missing parts + linked symbols with footprints
2024-03-09 Finalized schematic V1.0; minor changes to symbol library
    [BAT2024.kicad_pcb, BAT2024.kicad_sch, BAT_Materialliste.xlsx]
2024-03-10 Add temporary layout of footprints on PCB; generate placement-pdf
    [BAT2024.kicad_pcb, BAT2024.kicad_sch]
2024-03-12 Created first layout
    [BAT2024.kicad_pcb, BAT2024.kicad_sch]
2024-03-12 Generated gerber-files
    [BAT2024-B_Cu.gbl, BAT2024-B_Mask.gbs, BAT2024-B_Paste.gbp, BAT2024-B_Silkscreen.gbo, BAT2024-Edge_Cuts.gm1, BAT2024-F_Cu.gtl, BAT2024-F_Mask.gts, BAT2024-F_Paste.gtp]
2024-03-13 Add breakout-board to test SPI, PDM and LEDs
    [BAT_Breakout.kicad_pcb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]
2024-03-14 Removed most vias for stitching, minor general adjustments for layout
    [BAT2024-B_Cu.gbl, BAT2024-B_Mask.gbs, BAT2024-B_Paste.gbp, BAT2024-B_Silkscreen.gbo, BAT2024-Edge_Cuts.gm1, BAT2024-F_Cu.gtl, BAT2024-F_Mask.gts, BAT2024-F_Paste.gtp]
2024-03-20 Created V1-0 of adapterboard to convert dev-board to SWD programmer
    [BAT_SWD-Adapterboard-B_Cu.gbl, BAT_SWD-Adapterboard-B_Mask.gbs, BAT_SWD-Adapterboard-B_Paste.gbp, BAT_SWD-Adapterboard-B_Silkscreen.gbo, BAT_SWD-Adapterboard-Edge_Cuts.gm1, BAT_SWD-Adapterboard-F_Cu.gtl, BAT_SWD-Adapterboard-F_Mask.gts, BAT_SWD-Adapterboard-F_Paste.gtp]
2024-03-20 updated pcb library
2024-03-24 Add new functions to SPI
2024-03-24 Minor adjustments to SWD-Adapterboard
    [BAT_SWD-Adapterboard-B_Cu.gbl, BAT_SWD-Adapterboard-B_Mask.gbs, BAT_SWD-Adapterboard-B_Paste.gbp, BAT_SWD-Adapterboard-B_Silkscreen.gbo, BAT_SWD-Adapterboard-Edge_Cuts.gm1, BAT_SWD-Adapterboard-F_Cu.gtl, BAT_SWD-Adapterboard-F_Mask.gts, BAT_SWD-Adapterboard-F_Paste.gtp]
2024-03-25 Add IC outline to schematic; Add iBom for V1-1
    [BAT2024.kicad_sch]
2024-03-27 Add flowchart for I2C connection with LED driver IC
2024-03-28 Add I2C driver implementation to communicate with lp55231
2024-03-28 Created PCB V1-2; see documentation for changelog
    [BAT2024-B_Cu.gbl, BAT2024-B_Mask.gbs, BAT2024-B_Paste.gbp, BAT2024-B_Silkscreen.gbo, BAT2024-Edge_Cuts.gm1, BAT2024-F_Cu.gtl, BAT2024-F_Mask.gts, BAT2024-F_Paste.gtp]
2024-04-01 Doku stand: 20240401
    [BAT_Materialliste.xlsx]
2024-04-02 Add first version of LETIMER-driver
2024-04-14 Add exported matlab filter
2024-04-14 Add a-weighting filter test
2024-04-20 Add V1-3 of PCB. See changelog for more information
    [BAT2024-B_Cu.gbl, BAT2024-B_Mask.gbs, BAT2024-B_Paste.gbp, BAT2024-B_Silkscreen.gbo, BAT2024-Edge_Cuts.gm1, BAT2024-F_Cu.gtl, BAT2024-F_Mask.gts, BAT2024-F_Paste.gtp]
2024-04-21 Stand doku: 20240421
    [BAT_Berechnung_Energiebedarf_Gesamt.xlsx]
2024-04-27 Doku stand: 20240427
    [BAT_Berechnung_Speicherbedarf_Logging.xlsx]
2024-04-29 Add time measurements for different function calls
    [BAT_Zeitmessungen.xlsx]
2024-04-29 Add timer functionaliy to represent main loop
2024-04-29 Add spi timing measurements
2024-05-04 Stand doku: 20240504
    [BAT_Berechnung_Energiebedarf_Gesamt.xlsx, M2211_Z-Weighting.csv, MEMS_Z-Weighting.csv]
2024-05-11 Stand doku: 20240511
    [BAT_Berechnung_Energiebedarf_Gesamt.xlsx, BAT_Frequenzmessung_z-Gewichtung.csv]
2024-05-11 Add BOM V1-3
    [BAT2024.kicad_sch]
2024-05-13 Stand doku: 20240513
    [BAT_Frequenzmessung_Distanz.csv, BAT_Frequenzmessung_z-Gewichtung.csv, BAT_Frequenzmessung_z-Gewichtung_alt.csv]
2024-05-18 Stand doku: 20240518
    [BAT_Fremdwörterverzeichnis.xlsx, BAT_Frequenzmessung_Distanz.csv, BAT_Frequenzmessung_Kalibration.csv, BAT_Frequenzmessung_a-Gewichtung.csv, BAT_Frequenzmessung_c-Gewichtung.csv, BAT_Weighting_Matlab.csv]
2024-05-19 Add weighting filter
2024-05-19 Stand doku: 20240519
    [BAT2024.kicad_pcb, BAT_Fremdwörterverzeichnis.xlsx]
2024-05-20 Doku stand: 20240520
    [BAT_Frequenzmessung_Distanz.csv, BAT_Frequenzmessung_Geraet.csv, BAT_Frequenzmessung_Kalibration.csv, BAT_Frequenzmessung_Referenz.csv, BAT_Frequenzmessung_a-Gewichtung.csv, BAT_Frequenzmessung_c-Gewichtung.csv, M2211_Z-Weighting.csv, MEMS_Z-Weighting.csv]
2024-05-21 Stand doku: 20240521
    [BAT_Fremdwörterverzeichnis.xlsx]
2024-05-23 Doku stand: 20240523
    [BAT_Weighting_Matlab.csv]
2024-05-27 Doku stand: 20240527
    [BAT_Datenumrechnung_Rauschen.xlsx, BAT_Datenumrechnung_Sinus.xlsx, BAT_Fremdwörterverzeichnis.xlsx, BAT_Frequenzmessung_Distanz.csv, BAT_Frequenzmessung_Geraet.csv, BAT_Frequenzmessung_Referenz.csv, BAT_Mikrofon-Sinus-Offset.xlsx, BAT_Weighting_Matlab.xlsx]
2024-05-30 Doku V1-0
    [BAT_Datenumrechnung_Rauschen.xlsx, BAT_Rauschboden_Speisung.csv, BAT_Rauschboden_Startup.csv, PDM_CLK_Jitter_Oszilloskop.csv]
2024-05-30 Add filtercoefficients for reference
    [BAT_Frequenzmessung_Geraet.csv]
2024-06-06 Minor changes to the documentation
    [BAT_Datenumrechnung_Sinus_2.xlsx]
2024-06-06 Minor tweaks to filter-implementation; finalized software
